remmaTech12/omni-wheel/inverted_pendulum/modelling/pictures/animation/image/img_0.png

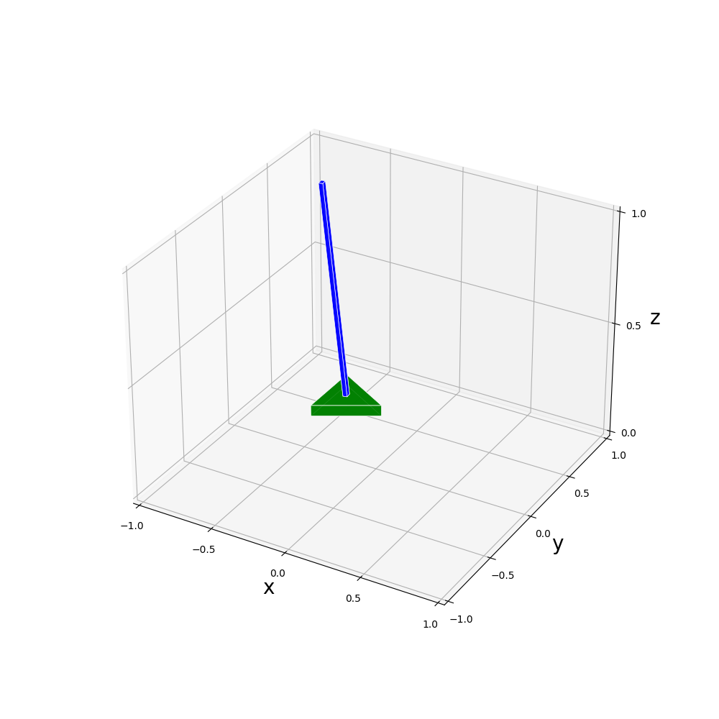
inverted_pendulum/modelling/pictures/animation/image/img_0.png
