remmaTech12/omni-wheel/inverted_pendulum/modelling/pictures/animation/image/img_8.png

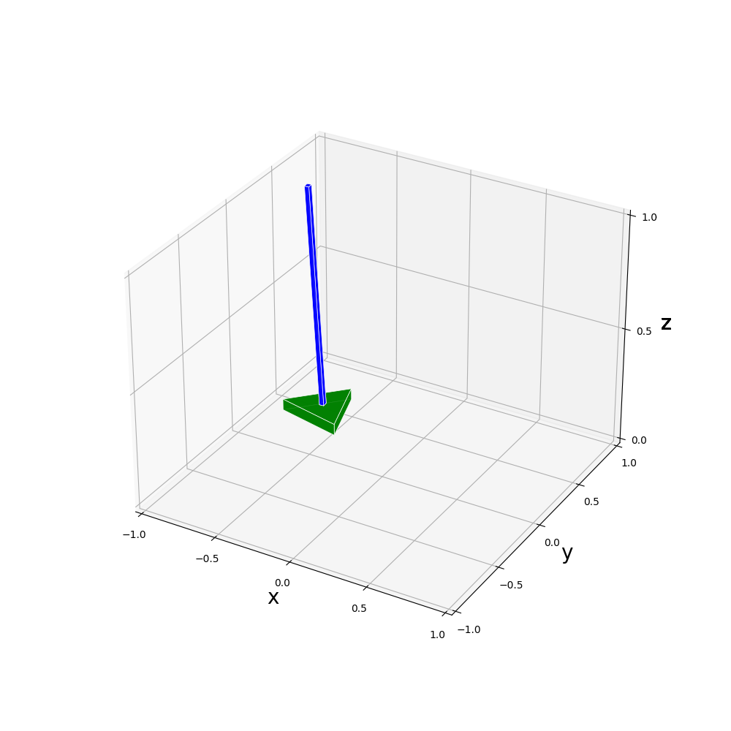
inverted_pendulum/modelling/pictures/animation/image/img_8.png
