remmaTech12/omni-wheel/inverted_pendulum/modelling/pictures/animation/image/img_51.png

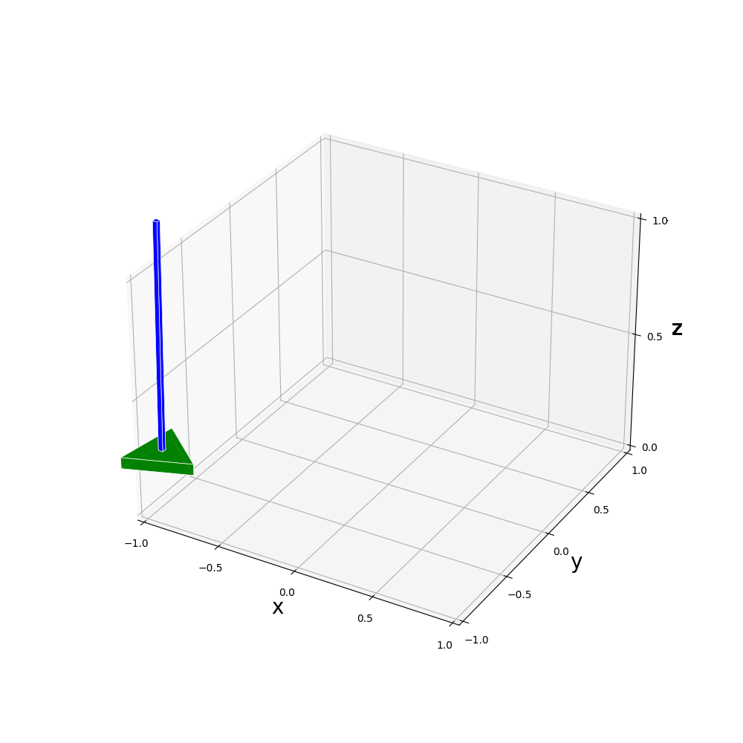
inverted_pendulum/modelling/pictures/animation/image/img_51.png
