remmaTech12/omni-wheel/inverted_pendulum/modelling/pictures/base_animation.png

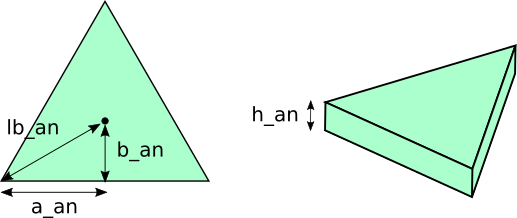
inverted_pendulum/modelling/pictures/base_animation.png
