remmaTech12/omni-wheel/inverted_pendulum/modelling/pictures/input.png

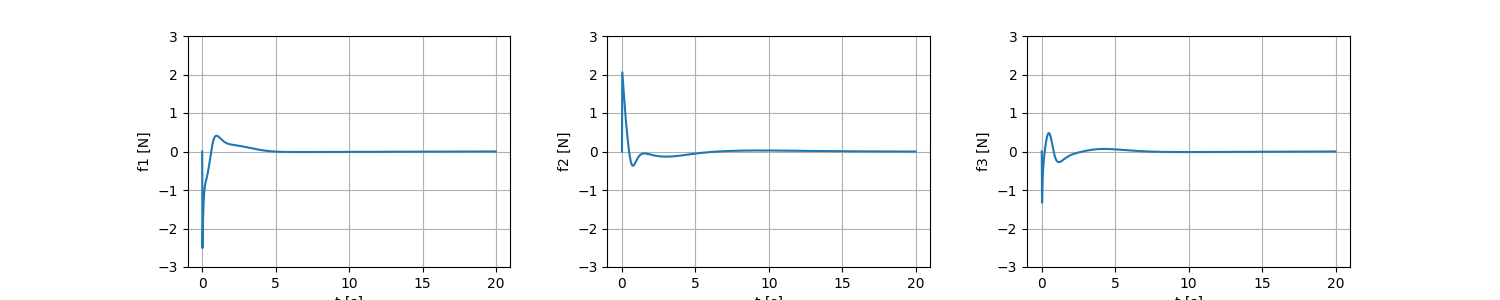
inverted_pendulum/modelling/pictures/input.png
