remmaTech12/omni-wheel/inverted_pendulum/modelling/pictures/modelling.png

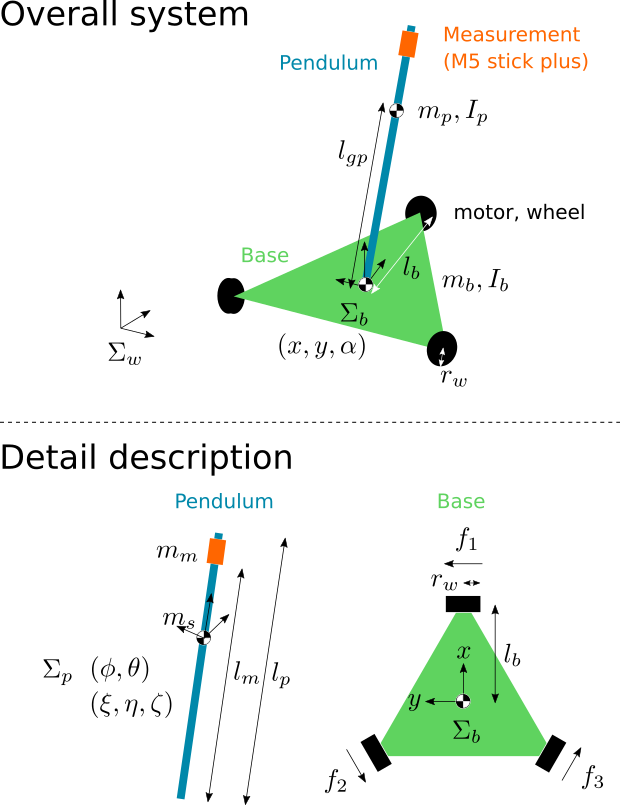
inverted_pendulum/modelling/pictures/modelling.png
