remmaTech12/omni-wheel/inverted_pendulum/modelling/pictures/modelling_2d.png

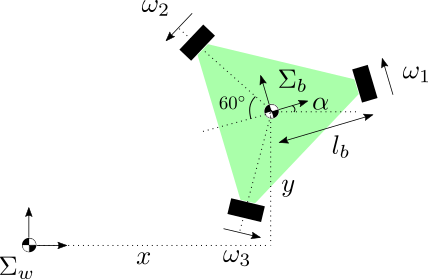
inverted_pendulum/modelling/pictures/modelling_2d.png
