remmaTech12/omni-wheel/inverted_pendulum/modelling/pictures/pendulum_offset.png

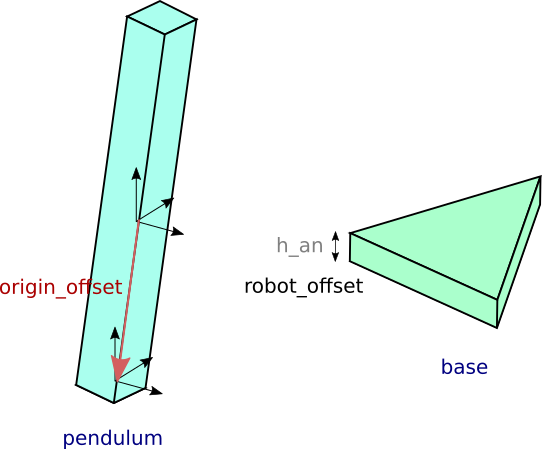
inverted_pendulum/modelling/pictures/pendulum_offset.png
