remmaTech12/omni-wheel/inverted_pendulum/modelling/pictures/phitheta.png

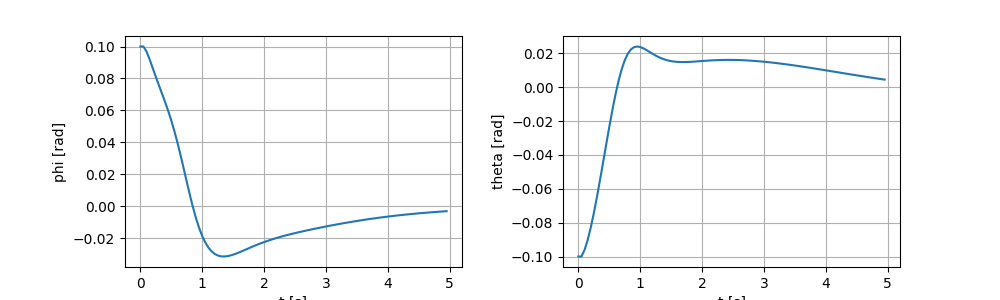
inverted_pendulum/modelling/pictures/phitheta.png
