remmaTech12/omni-wheel/inverted_pendulum/modelling/pictures/xyalpha.png

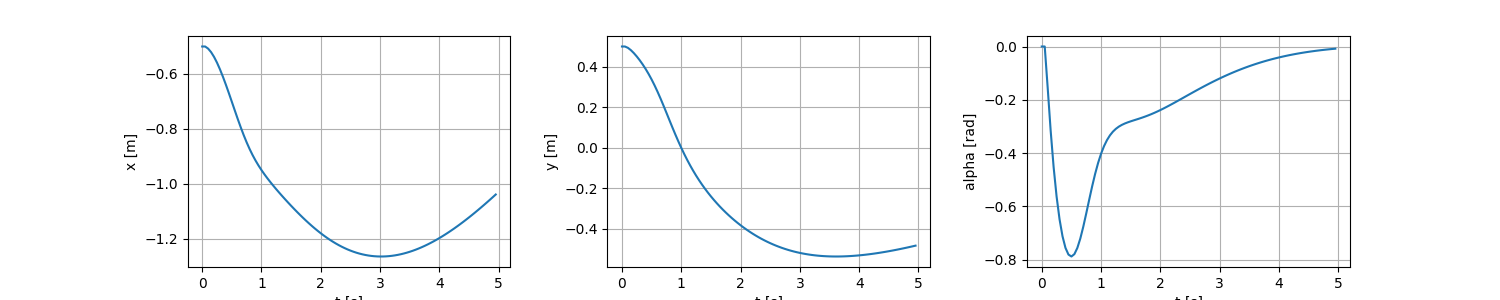
inverted_pendulum/modelling/pictures/xyalpha.png
