remmaTech12/omni-wheel/circuit/remote_controller/remote_controller_bom_pcbway.xlsx

Sheet: remote controller
 |  |  | Remote controller BOM
Item # | *Designator | *Qty | Manufacturer | *Mfg Part # | Value | Description / Value | *Package/Footprint | Type | Purchase Link | Your Instructions / Notes
1 | C1, C4, | 2 | KYOCERA AVX | 0603YD106MAT2A | 10uF | Unpolarized capacitor | 0603 inch | SMD | https://www.mouser.jp/ProductDetail/KYOCERA-AVX/0603YD106MAT2A
2 | C2, C5, C6, C8, | 4 | KEMET | C0603C104K1RACTU | 0.1uF | Unpolarized capacitor | 0603 inch | SMD | https://www.mouser.jp/ProductDetail/KEMET/C0603C104K1RACTU
3 | C3, | 1 | KYOCERA AVX | KAF15BR71E224KT | 22uF | Unpolarized capacitor | 0603 inch | SMD | https://www.mouser.jp/ProductDetail/KYOCERA-AVX/KAF15BR71E224KT
4 | C7, | 1 | KEMET | C0603C475K8PACTU | 4.7uF | Unpolarized capacitor | 0603 inch | SMD | https://www.mouser.jp/ProductDetail/KEMET/C0603C475K8PACTU
5 | D1, D3, D4, D6, D7, D8, D9, D10, D11, D12, D13, | 11 | Bivar | SM0603UBWC | LED | Light emitting diode | 0603 inch | SMD | https://www.mouser.jp/ProductDetail/Bivar/SM0603UBWC?qs=hWDdE2Pc5RAVU9aZAE1txQ%3D%3D
6 | D2, | 1 | Littelfuse | SP0503BAHTG | SP0503BAHT | TVS Diode Array, 5.5V Standoff, 3 Channels SOT-143 package | SOT-143 | SMD | https://www.mouser.jp/ProductDetail/Littelfuse/SP0503BAHTG?qs=uD%2FdkN7XIa0NTYXwHdELYA%3D%3D
7 | D5, | 1 | Bourns | CD0603-B0340R | D_Schottky | Schottky diode | 0603 inch | SMD | https://www.mouser.jp/ProductDetail/Bourns/CD0603-B0340R?qs=xhbEVWpZdWee9K23%252B3DSjQ%3D%3D
8 | J1, | 1 |  |  | Male connector | Generic connector, single row, 01x02, script generated | 1x02_P2.54mm | THT |  | No need to mount this part on the board
9 | J2, | 1 | Amphenol Commercial Products | 12401610E4#2A | USB_C_Receptacle_USB2.0 | USB 2.0-only Type-C Receptacle connector | USB_C_Receptacle | SMD | https://www.mouser.jp/ProductDetail/Amphenol-Commercial-Products/12401610E42A?qs=EgDjlb95zqAWvChv41w5lg%3D%3D
10 | Q1, Q2, | 2 | Comchip Technology | SS8050-G | SS8050-G | Low Voltage High Current NPN Transistor | SOT-23 | SMD | https://www.mouser.jp/ProductDetail/Comchip-Technology/SS8050-G
11 | R1, R2, R4, R12, | 4 | Vishay / Beyschlag | MCT0603MG1002BP500 | 10kΩ | Resistor | 0603 inch | SMD | https://www.mouser.jp/ProductDetail/Vishay-Beyschlag/MCT0603MG1002BP500?qs=Y0Uzf4wQF3kTztUxcSxY1w%3D%3D
12 | R3, | 1 | Vishay / Beyschlag | MCT06030C1470FP500 | 147Ω | Resistor | 0603 inch | SMD | https://www.mouser.jp/ProductDetail/Vishay-Beyschlag/MCT06030C1470FP500
13 | R5, | 1 | YAGEO | RT0603BRB0722K1L | 22.1kΩ | Resistor | 0603 inch | SMD | https://www.mouser.jp/ProductDetail/YAGEO/RT0603BRB0722K1L
14 | R6, R10, | 2 | Vishay / Dale | RCS06035K10FKEA | 5.1kΩ | Resistor | 0603 inch | SMD | https://www.mouser.jp/ProductDetail/Vishay-Dale/RCS06035K10FKEA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
15 | R7, R8, R19, R20, R21, R22, R27, R28, R29, R30, | 10 | Littelfuse | 0603L001/60YR | 100Ω | Resistor | 0603 inch | SMD | https://www.mouser.jp/ProductDetail/Littelfuse/0603L001-60YR?qs=vmHwEFxEFR%252Bqpk0gfi6KUQ%3D%3D
16 | R9, | 1 | Vishay / Dale | TNPW060347K5BEEA | 47.5kΩ | Resistor | 0603 inch | SMD | https://www.mouser.jp/ProductDetail/Vishay-Dale/TNPW060347K5BEEA
17 | R11, | 1 | Vishay / BC Components | NTCS0603E3202GLT | 2kΩ | Resistor | 0603 inch | SMD | https://www.mouser.jp/ProductDetail/Vishay-BC-Components/NTCS0603E3202GLT?qs=%2FWiulJ9oly6RDPZsx8Fw8g%3D%3D
18 | R13, R14, | 2 | Vishay / Beyschlag | MCT0603HZ0000ZP500 | 0Ω | Resistor | 0603 inch | SMD | https://www.mouser.jp/ProductDetail/Vishay-Beyschlag/MCT0603HZ0000ZP500
19 | R15, R16, R17, R18, R23 R24, R25, R26, | 8 | Vishay / BC Components | NTCS0603E3502FLT | 5kΩ | Resistor | 0603 inch | SMD | https://www.mouser.jp/ProductDetail/Vishay-BC-Components/NTCS0603E3502FLT?qs=doiCPypUmgFTT6mDFv6oKA%3D%3D
20 | SW1, SW2, | 2 | C&K | KMR231NGLFS | SW_Push | Push button switch, generic, two pins | KMR2 | SMD | https://www.mouser.jp/ProductDetail/CK/KMR231NGLFS?qs=sb%252But3Lm4x1Y5NsXXdZx2g%3D%3D
21 | SW3, SW4, SW5, SW6, SW7, SW8, SW9, SW10, | 8 | Diptronics | DTSM-65N-V-B | SW_Push | Push button switch, generic, two pins | 6x6mm_H9.5mm | SMD | https://www.mouser.jp/ProductDetail/Diptronics/DTSM-65N-V-B?qs=gTYE2QTfZfSXwXAGPNekUg%3D%3D
22 | U1, | 1 | Analog Devices | LT1963AEST-3.3#PBF | LT1963AxST-3.3 | 3.3V, 1.5A, Low Noise, Fast Transient Response LDO Regulator, SOT-223 | SOT-223-3 | SMD | https://www.mouser.jp/ProductDetail/Analog-Devices/LT1963AEST-3.3PBF?qs=ytflclh7QUWACCdXyVJ5gA%3D%3D
23 | U2, | 1 | Espressif Systems | ESP32-WROVER-B-N8R8 | ESP32-WROVER-B | ESP32-WROVER-B | ESP32-WROVER-B | SMD | https://www.digikey.jp/ja/products/detail/espressif-systems/ESP32-WROVER-B-N8R8/9857843 | Should have 技適 mark to use in Japan.
24 | U3, | 1 | Silicon Labs | CP2102N-A02-GQFN28 | CP2102N-Axx-xQFN28 | USB to UART master bridge, QFN-28 | Package_DFN_QFN: QFN-28-1EP 5x5mm_P0.5mm_EP3.35x3.35mm | SMD | https://www.mouser.jp/ProductDetail/Silicon-Labs/CP2102N-A02-GQFN28?qs=u16ybLDytRaSBkSkyjYFiA%3D%3D

Sheet: sample
Item # | *Designator | *Qty | Manufacturer | *Mfg Part # | Description / Value | *Package/Footprint | Type | Your Instructions / Notes
1 | U1 | 1 | Linear | LTC3780EG#PBF | IC BUCK-BOOST CONV 24-SSOP | 24-SSOP | SMD
2 | U2,U4 | 2 | Fairchild | LM2904M | IC OPAMP DUAL -40-85 C 8-SOIC | 8-SOIC | DNS
3 | U3 | 1 | ON | LM317MBDTG | LM317M IC REG VOLT ADJ 500MA DPAK | DPAK | SMD
4 | U5 | 1 | Microchip | PIC16F690-I/SS | IC PIC MCU FLASH 4KX14 20SSOP | 20SSOP | SMD
5 | Q1 | 1 | Diodes Inc | GBJ10005-F | RECT BRIDGE GPP 50V 10A GBJ | GBJ | SMD
6 | R14,R18 | 2 | Panasonic | ERJ-6ENF4701V | RES 4.70K OHM 1/8W 1% 0805 SMD | 0805 | SMD
7 | R15 | 1 | Susumu | RL3720WT-R022-F | RES .022 OHM 1W 1% 0815 SMD | 0815 | SMD
8 | R16, R31 | 2 | Panasonic | ERJ-6ENF4702V | RES 47.0K OHM 1/8W 1% 0805 SMD | 0805 | SMD
9 | C5 | 1 | Murata | GRM21BR71C225KA12L | CAP CER 2.2UF 16V X7R 0805 | 0805 | SMD
10 | C7 | 1 | Murata | GRM21BR71C475KA73L | CAP CER 4.7UF 16V X7R 0805 | 0805 | DNS
11 | C8,C22 | 2 | Muruta | GRM21BR71C105KA01L | CAP CER 1.0UF 16V 10% X7R 0805 | 0805 | SMD
12 | CN6 | 1 | Molex | 538-53398-0671 | 1.25mm Connectors VERTICAL HDR SMT 6P | SMT 6P | SMD
13 | L1,L2 | 2 | Coiltronics | DR127-150-R | INDUCTOR SHIELD PWR 15UH SMD | SMD | SMD
14 | L3 | 1 | TDK | ACM1211-102-2PL-TL | CHOKE COMM MODE 1000 OHM 6A SM | SMD | SMD
15 | CN3,CN4 | 2 | Molex | 53047-0510 | CONN HEADER 5POS 1.25MM VERT TIN | 5POS | thru-hole

Sheet: kicad sheet
Reference | Quantity | Value | Component name | Description | Footprint | Purchase link
C1, C4, | 2 | 10u | C | Unpolarized capacitor | Capacitor_SMD:C_0603_1608Metric | https://www.mouser.jp/ProductDetail/KYOCERA-AVX/0603YD106MAT2A
C2, C5, C6, C8, | 4 | 0.1u | C | Unpolarized capacitor | Capacitor_SMD:C_0603_1608Metric | https://www.mouser.jp/ProductDetail/KEMET/C0603C104K1RACTU
C3, | 1 | 22u | C | Unpolarized capacitor | Capacitor_SMD:C_0603_1608Metric | https://www.mouser.jp/ProductDetail/KYOCERA-AVX/KAF15BR71E224KT
C7, | 1 | 4.7u | C | Unpolarized capacitor | Capacitor_SMD:C_0603_1608Metric | https://www.mouser.jp/ProductDetail/KEMET/C0603C475K8PACTU
D1, D3, D4, D6, D7, D8, D9, D10, D11, D12, D13, | 11 | LED | LED | Light emitting diode | Diode_SMD:D_0603_1608Metric | https://www.mouser.jp/ProductDetail/Bivar/SM0603UBWC?qs=hWDdE2Pc5RAVU9aZAE1txQ%3D%3D
D2, | 1 | SP0503BAHT | SP0503BAHT | TVS Diode Array, 5.5V Standoff, 3 Channels, SOT-143 package | Package_TO_SOT_SMD:SOT-143 | https://www.mouser.jp/ProductDetail/Littelfuse/SP0503BAHTG?qs=uD%2FdkN7XIa0NTYXwHdELYA%3D%3D
D5, | 1 | D_Schottky | D_Schottky | Schottky diode | Diode_SMD:D_0603_1608Metric | https://www.mouser.jp/ProductDetail/Bourns/CD0603-B0340R?qs=xhbEVWpZdWee9K23%252B3DSjQ%3D%3D
J1, | 1 | Conn_01x02_Male | Conn_01x02_Male | Generic connector, single row, 01x02, script generated | Connector_PinHeader_2.54mm:PinHeader_1x02_P2.54mm_Vertical
J2, | 1 | USB_C_Receptacle_USB2.0 | USB_C_Receptacle_USB2.0 | USB 2.0-only Type-C Receptacle connector | Connector_USB:USB_C_Receptacle_Amphenol_12401610E4-2A | https://www.mouser.jp/ProductDetail/Amphenol-Commercial-Products/12401610E42A?qs=EgDjlb95zqAWvChv41w5lg%3D%3D
Q1, Q2, | 2 | SS8050-G | S8050 | 0.7A Ic, 20V Vce, Low Voltage High Current NPN Transistor, TO-92 | Package_TO_SOT_SMD:SOT-23 | https://www.mouser.jp/ProductDetail/Comchip-Technology/SS8050-G
R1, R2, R4, R12, | 4 | 10k | R | Resistor | Resistor_SMD:R_0603_1608Metric | https://www.mouser.jp/ProductDetail/Vishay-Beyschlag/MCT0603MG1002BP500?qs=Y0Uzf4wQF3kTztUxcSxY1w%3D%3D
R3, | 1 | 147 | R | Resistor | Resistor_SMD:R_0603_1608Metric | https://www.mouser.jp/ProductDetail/Vishay-Beyschlag/MCT06030C1470FP500
R5, | 1 | 22.1k | R | Resistor | Resistor_SMD:R_0603_1608Metric | https://www.mouser.jp/ProductDetail/YAGEO/RT0603BRB0722K1L
R6, R10, | 2 | 5.1k | R | Resistor | Resistor_SMD:R_0603_1608Metric | https://www.mouser.jp/ProductDetail/Vishay-Dale/RCS06035K10FKEA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
R7, R8, R19, R20, R21, R22, R27, R28, R29, R30, | 10 | 100 | R | Resistor | Resistor_SMD:R_0603_1608Metric | https://www.mouser.jp/ProductDetail/Littelfuse/0603L001-60YR?qs=vmHwEFxEFR%252Bqpk0gfi6KUQ%3D%3D
R9, | 1 | 47.5k | R | Resistor | Resistor_SMD:R_0603_1608Metric | https://www.mouser.jp/ProductDetail/Vishay-Dale/TNPW060347K5BEEA
R11, | 1 | 2k | R | Resistor | Resistor_SMD:R_0603_1608Metric | https://www.mouser.jp/ProductDetail/Vishay-BC-Components/NTCS0603E3202GLT?qs=%2FWiulJ9oly6RDPZsx8Fw8g%3D%3D
R13, R14, | 2 | 0 | R | Resistor | Resistor_SMD:R_0603_1608Metric | https://www.mouser.jp/ProductDetail/Vishay-Beyschlag/MCT0603HZ0000ZP500
R15, R16, R17, R18, R23, R24, R25, R26, | 8 | 5k | R | Resistor | Resistor_SMD:R_0603_1608Metric | https://www.mouser.jp/ProductDetail/Vishay-BC-Components/NTCS0603E3502FLT?qs=doiCPypUmgFTT6mDFv6oKA%3D%3D
SW1, SW2, | 2 | SW_Push | SW_Push | Push button switch, generic, two pins | Button_Switch_SMD:SW_Push_1P1T_NO_CK_KMR2 | https://www.mouser.jp/ProductDetail/CK/KMR231NGLFS?qs=sb%252But3Lm4x1Y5NsXXdZx2g%3D%3D
SW3, SW4, SW5, SW6, SW7, SW8, SW9, SW10, | 8 | SW_Push | SW_Push | Push button switch, generic, two pins | Button_Switch_SMD:SW_Push_1P1T_NO_6x6mm_H9.5mm | https://www.mouser.jp/ProductDetail/Diptronics/DTSM-65N-V-B?qs=gTYE2QTfZfSXwXAGPNekUg%3D%3D
U1, | 1 | LT1963AxST-3.3 | LT1963AxST-3.3 | 3.3V, 1.5A, Low Noise, Fast Transient Response LDO Regulator, SOT-223 | Package_TO_SOT_SMD:SOT-223-3_TabPin2 | https://www.mouser.jp/ProductDetail/Analog-Devices/LT1963AEST-3.3PBF?qs=ytflclh7QUWACCdXyVJ5gA%3D%3D
U2, | 1 | ESP32-WROVER-B | ESP32-WROVER-B | ESP32-WROVER-B | ESP32-WROVER-B:MODULE_ESP32-WROVER-B | https://www.digikey.jp/ja/products/detail/espressif-systems/ESP32-WROVER-B-N8R8/9857843
U3, | 1 | CP2102N-Axx-xQFN28 | CP2102N-Axx-xQFN28 | USB to UART master bridge, QFN-28 | Package_DFN_QFN:QFN-28-1EP_5x5mm_P0.5mm_EP3.35x3.35mm | https://www.mouser.jp/ProductDetail/Silicon-Labs/CP2102N-A02-GQFN28?qs=u16ybLDytRaSBkSkyjYFiA%3D%3D
