remmaTech12/omni-wheel/circuit/remote_controller/purchase_order/bom.xls

PCBWay Bom Quotation, Product No.:T-1JP1W790621A
Item # | *Designator | *Qty | Manufacturer | *Mfg Part # | Description / Value | Vendor Part # | *Package/Footprint | Mounting Type | Your Instructions / Notes | *Unit Price(1 set) | *Total | *Delivery Time | *Actual Purchase Mfg Part # | *PCBWay Note | Customer Reply | PCBWay Update
1 | C1, C4 | 2 | KYOCERA AVX | 0603YD106MAT2A | 10uF『 』Unpolarized capacitor | https://www.mouser.jp/ProductDetail/KYOCERA-AVX/0603YD106MAT2A | 0603 inch | SMD |  | $1.084 | $2.168 | 7-10 Workdays
2 | C2, C5, C6, C8 | 4 | KEMET | C0603C104K1RACTU | 0.1uF『 』Unpolarized capacitor | https://www.mouser.jp/ProductDetail/KEMET/C0603C104K1RACTU | 0603 inch | SMD |  | $0.255 | $1.020 | 15 Workdays
3 | C3 | 1 | KYOCERA AVX | KAF15BR71E224KT | 22uF『 』Unpolarized capacitor | https://www.mouser.jp/ProductDetail/TAIYO-YUDEN/MEASP105CB5226MF1A01?qs=Z%252BL2brAPG1ICjjPsHUfgZw%3D%3D | 0603 inch | SMD |  | $1.303 | $1.303 | 15 Workdays | 06034D226MAT2A
4 | C7 | 1 | KEMET | C0603C475K8PACTU | 4.7uF『 』Unpolarized capacitor | https://www.mouser.jp/ProductDetail/KEMET/C0603C475K8PACTU | 0603 inch | SMD |  | $0.364 | $0.364 | 15 Workdays
5 | D1, D3, D4, D6, D7, D8,D9, D10, D11, D12, D13 | 11 | Bivar | SM0603UBWC | LED『 』Light emitting diode | https://www.mouser.jp/ProductDetail/Bivar/SM0603UBWC?qs=hWDdE2Pc5RAVU9aZAE1txQ%3D%3D | 0603 inch | SMD |  | $1.163 | $12.793 | 7-10 Workdays
6 | D2 | 1 | Littelfuse | SP0503BAHTG | SP0503BAHT『 』TVS Diode Array, 5.5V Standoff, 3 ChannelsSOT-143 package | https://www.mouser.jp/ProductDetail/Littelfuse/SP0503BAHTG?qs=uD%2FdkN7XIa0NTYXwHdELYA%3D%3D | SOT-143 | SMD |  | $0.191 | $0.191
7 | D5 | 1 | Bourns | CD0603-B0340R | D_Schottky『 』Schottky diode | https://www.mouser.jp/ProductDetail/Bourns/CD0603-B0340R?qs=xhbEVWpZdWee9K23%252B3DSjQ%3D%3D | 0603 inch | SMD |  | $0.404 | $0.404 | 15 Workdays
8 | J1 | 1 |  |  | Male connector『 』Generic connector, single row,01x02, script generated |  | 1x02_P2.54mm | THT | No need to mount this part on the board |  |  |  |  | 不买不贴[DNP不要贴];
9 | J2 | 1 | Amphenol Commercial Products | 12401610E4#2A | USB_C_Receptacle_USB2.0『 』USB 2.0-only Type-C Receptacle connector | https://www.mouser.jp/ProductDetail/Amphenol-Commercial-Products/12401610E42A?qs=EgDjlb95zqAWvChv41w5lg%3D%3D | USB_C_Receptacle | SMD |  | $4.365 | $4.365 | 7-10 Workdays
10 | Q1, Q2 | 2 | Comchip Technology | SS8050-G | SS8050-G『 』Low Voltage High Current NPN Transistor | https://www.mouser.jp/ProductDetail/Comchip-Technology/SS8050-G | SOT-23 | SMD |  | $0.688 | $1.376 | 7-10 Workdays
11 | R1, R2, R4, R12 | 4 | Vishay / Beyschlag | MCT0603MG1002BP500 | 10kΩ『 』Resistor | https://www.mouser.jp/ProductDetail/Vishay-Beyschlag/MCT0603MG1002BP500?qs=Y0Uzf4wQF3kTztUxcSxY1w%3D%3D | 0603 inch | SMD |  | $2.211 | $8.844 | 7-10 Workdays
12 | R3 | 1 | Vishay / Beyschlag | MCT06030C1470FP500 | 147Ω『 』Resistor | https://www.mouser.jp/ProductDetail/Vishay-Beyschlag/MCT06030C1470FP500 | 0603 inch | SMD |  | $0.277 | $0.277 | 7-10 Workdays
13 | R5 | 1 | YAGEO | RT0603BRB0722K1L | 22.1kΩ『 』Resistor | https://www.mouser.jp/ProductDetail/YAGEO/RT0603BRB0722K1L | 0603 inch | SMD |  | $1.196 | $1.196 | 7-10 Workdays
14 | R6, R10 | 2 | Vishay / Dale | RCS06035K10FKEA | 5.1kΩ『 』Resistor | https://www.mouser.jp/ProductDetail/Vishay-Dale/RCS06035K10FKEA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 | 0603 inch | SMD |  | $0.104 | $0.208 | 15 Workdays
15 | R7, R8, R19, R20, R21,R22, R27, R28, R29, R30 | 10 | Littelfuse | 0603L001/60YR | 100Ω『 』Resistor | https://www.mouser.jp/ProductDetail/Littelfuse/0603L001-60YR?qs=vmHwEFxEFR%252Bqpk0gfi6KUQ%3D%3D | 0603 inch | SMD |  | $1.731 | $17.310 | 7-10 Workdays
16 | R9 | 1 | Vishay / Dale | TNPW060347K5BEEA | 47.5kΩ『 』Resistor | https://www.mouser.jp/ProductDetail/Vishay-Dale/TNPW060347K5BEEA | 0603 inch | SMD |  | $0.738 | $0.738 | 15 Workdays
17 | R11 | 1 | Vishay / BC Components | NTCS0603E3202GLT | 2kΩ『 』Resistor | https://www.mouser.jp/ProductDetail/Vishay-BC-Components/NTCS0603E3202GLT?qs=%2FWiulJ9oly6RDPZsx8Fw8g%3D%3D | 0603 inch | SMD |  | $4.677 | $4.677 | 7-10 Workdays
18 | R13, R14 | 2 | Vishay / Beyschlag | MCT0603HZ0000ZP500 | 0Ω『 』Resistor | https://www.mouser.jp/ProductDetail/Vishay-Beyschlag/MCT0603HZ0000ZP500 | 0603 inch | SMD |  | $0.561 | $1.122 | 7-10 Workdays
19 | R15, R16, R17, R18, R23R24, R25, R26 | 8 | Vishay / BC Components | NTCS0603E3502FLT | 5kΩ『 』Resistor | https://www.mouser.jp/ProductDetail/Vishay-BC-Components/NTCS0603E3502FLT?qs=doiCPypUmgFTT6mDFv6oKA%3D%3D | 0603 inch | SMD |  | $0.697 | $5.576 | 15 Workdays
20 | SW1, SW2 | 2 | C&K | KMR231NGLFS | SW_Push『 』Push button switch, generic, two pins | https://www.mouser.jp/ProductDetail/CK/KMR231NGLFS?qs=sb%252But3Lm4x1Y5NsXXdZx2g%3D%3D | KMR2 | SMD |  | $1.188 | $2.376 | 15 Workdays | KMR231NG LFS
21 | SW3, SW4, SW5, SW6, SW7,SW8, SW9, SW10 | 8 | Diptronics | DTSM-65N-V-B | SW_Push『 』Push button switch, generic, two pins | https://www.mouser.jp/ProductDetail/Diptronics/DTSM-65N-V-B?qs=gTYE2QTfZfSXwXAGPNekUg%3D%3D | 6x6mm_H9.5mm | SMD |  | $0.591 | $4.728 | 7-10 Workdays
22 | U1 | 1 | Analog Devices | LT1963AEST-3.3#PBF | LT1963AxST-3.3『 』3.3V,1.5A,LowNoise,FastTransientResponseLDORegulator,SOT-223 | https://www.mouser.jp/ProductDetail/Analog-Devices/LT1963AEST-3.3PBF?qs=ytflclh7QUWACCdXyVJ5gA%3D%3D | SOT-223-3 | SMD |  | $10.854 | $10.854 | 15 Workdays
23 | U2 | 1 | Espressif Systems | ESP32-WROVER-B-N8R8 | ESP32-WROVER-B『 』ESP32-WROVER-B | https://www.digikey.jp/ja/products/detail/espressif-systems/ESP32-WROVER-B-N8R8/9857843 | ESP32-WROVER-B | SMD | Should have 技適 mark to use in Japan. | $13.671 | $13.671 |  |  | Should have 技適 mark to use in Japan.
24 | U3 | 1 | Silicon Labs | CP2102N-A02-GQFN28 | CP2102N-Axx-xQFN28『 』USB to UART master bridge, QFN-28 | https://www.mouser.jp/ProductDetail/Silicon-Labs/CP2102N-A02-GQFN28?qs=u16ybLDytRaSBkSkyjYFiA%3D%3D | Package_DFN_QFN:QFN-281EP5x5mm_P0.5mm_EP3.35x3.35mm | SMD |  | $6.405 | $6.405 | 15 Workdays
 |  |  |  |  |  |  |  |  |  | Component Cost | $101.97
 |  |  |  |  |  |  |  |  |  | Assembly Cost | $30.00
 |  |  |  |  |  |  |  |  |  | PCB Cost | $58.22
 |  |  |  |  |  |  |  |  |  | V0 Member 0% off | $0.00
 |  |  |  |  |  |  |  |  |  | All Total 1 Sets | $190.19
