remmaTech12/omni-wheel/circuit/omni_wheel/purchase_order/20241202/bom.xls

PCBWay Bom Quotation, Product No.:T-1JP6W790621A
Item # | *Designator | *Qty | Manufacturer | *Mfg Part # | Description / Value | *Package/Footprint | Mounting Type | Your Instructions / Notes | *Unit Price(1 set) | *Total | *Delivery Time | *Actual Purchase Mfg Part # | *PCBWay Note | Customer Reply | PCBWay Update
1 | C1, C6 | 2 | KYOCERA AVX | 0603ZW106MAT2A | 10uF | Capacitor_SMD:C_0603_1608Metric | SMD | https://www.mouser.jp/ProductDetail/KYOCERA-AVX/0603ZW106MAT2A?qs=BZBei1rCqCDILT8BMORbpw%3D%3D | $0.693 | $1.386
2 | C2, C4, C5, C8, C9, C11, C12, C13, C14, C15, C16, C17 | 12 | KYOCERA AVX | KAM15AR71C104KM | 0.1uF | Capacitor_SMD:C_0603_1608Metric | SMD | https://www.mouser.jp/ProductDetail/KYOCERA-AVX/KAM15AR71C104KM?qs=Jm2GQyTW%2FbjvjfiJhcHTCg%3D%3D | $0.139 | $1.668
3 | C3 | 1 | KYOCERA AVX | 0603ZD226MAT2A | 22uF | Capacitor_SMD:C_0603_1608Metric | SMD | https://www.mouser.jp/ProductDetail/KYOCERA-AVX/0603ZD226MAT2A?qs=sSYV1F9c5cE%2FKdrrBmQkqw%3D%3D | $0.504 | $0.504
4 | C7 | 1 | KYOCERA AVX | 06036D475MAT2A | 4.7uF | Capacitor_SMD:C_0603_1608Metric | SMD | https://www.mouser.jp/ProductDetail/KYOCERA-AVX/06036D475MAT2A?qs=G62aafFtBAdLQjkZwFspeQ%3D%3D | $0.231 | $0.231
5 | C10 | 1 | Vishay / Vitramon | VJ0603Y682KXBAC31X | 6.8nF | Capacitor_SMD:C_0603_1608Metric | SMD | https://www.mouser.jp/ProductDetail/Vishay-Vitramon/VJ0603Y682KXBAC31X | $0.567 | $0.567
6 | D1, D2 | 2 | Bivar | SM0603URC | LED | Diode_SMD:D_0603_1608Metric | SMD | https://www.mouser.jp/ProductDetail/Bivar/SM0603URC?qs=hWDdE2Pc5RAmyCtviNtSxQ%3D%3D | $0.512 | $1.024
7 | D3 | 1 | Littelfuse | SP0503BAHTG | SP0503BAHT | Package_TO_SOT_SMD:SOT-143 | SMD | https://www.mouser.jp/ProductDetail/Littelfuse/SP0503BAHTG?qs=uD%2FdkN7XIa0NTYXwHdELYA%3D%3D | $0.415 | $0.415
8 | D4 | 1 | Comchip Technology | CDBU70-HF | D_Schottky | Diode_SMD:D_0603_1608Metric | SMD | https://www.mouser.jp/ProductDetail/Comchip-Technology/CDBU70-HF?qs=2qJf6qQ4IOL3%2FIGqjls%252B4w%3D%3D | $0.982 | $0.982 | 7-10 Workdays
9 | J1 | 1 | Adam Tech | PH1RB-02-UA | Conn_01x02_Male | Connector_PinSocket_2.54mm:PinSocket_1x02_P2.54mm_Vertical | THT | https://www.digikey.jp/ja/products/detail/adam-tech/PH1RB-02-UA/9830333?productid=9830333&gad_source=1 』PCB front side is upward | $0.237 | $0.237 | 7-10 Workdays
10 | J2 | 1 | Amphenol Commercial Products | 12401610E4#2A | USB_C_Receptacle_USB2.0 | Connector_USB:USB_C_Receptacle_Amphenol_12401610E4-2A | SMD | https://www.mouser.jp/ProductDetail/Amphenol-Commercial-Products/12401610E42A?qs=EgDjlb95zqAWvChv41w5lg%3D%3D | $2.013 | $2.013
11 | J3, J4, J5 | 3 | Würth Elektronik | 61300611121 | Conn_01x06_Male | Connector_PinHeader_2.54mm:PinHeader_1x06_P2.54mm_Vertical | THT | https://www.digikey.jp/ja/products/detail/w%C3%BCrth-elektronik/61300611121/4846833?productid=4846833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 』PCB front side is upward | $0.549 | $1.647 | 7-10 Workdays
12 | Q1, Q2 | 2 | Comchip Technology | SS8050-G | SS8050-G | Package_TO_SOT_SMD:SOT-23 | SMD | https://www.mouser.jp/ProductDetail/Comchip-Technology/SS8050-G | $0.512 | $1.024 |  |  | brand:CJ(江苏长电/长晶) ,not Comchip Technology ,pls confirm.
13 | R1, R2, R4, R12, R15, R16, R17, R18, R19, R20 | 10 | Vishay / Beyschlag | MCT06030D1002BP500 | 10kΩ | Resistor_SMD:R_0603_1608Metric | SMD | https://www.mouser.jp/ProductDetail/Vishay-Beyschlag/MCT06030D1002BP500?qs=ncxkyCpAYDAJSzgYSRSsnA%3D%3D | $0.232 | $2.320
14 | R3 | 1 | Vishay / Dale | CRCW0603147RFKTA | 147Ω | Resistor_SMD:R_0603_1608Metric | SMD | https://www.mouser.jp/ProductDetail/Vishay-Dale/CRCW0603147RFKTA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 | $0.092 | $0.092
15 | R5 | 1 | Vishay / BC Components | NTCS0603E3502HLT | 5kΩ | Resistor_SMD:R_0603_1608Metric | SMD | https://www.mouser.jp/ProductDetail/Vishay-BC-Components/NTCS0603E3502HLT?qs=doiCPypUmgFTmF9ZnhJHyQ%3D%3D | $1.470 | $1.470
16 | R6 | 1 | Bourns | CR0603-JW-101ELF | 100Ω | Resistor_SMD:R_0603_1608Metric | SMD | https://www.mouser.jp/ProductDetail/Bourns/CR0603-JW-101ELF?qs=jAUlru4btJFOerhakJcyhQ%3D%3D | $0.042 | $0.042
17 | R7 | 1 | Vishay / Dale | TNPW060322K1BEEA | 22.1kΩ | Resistor_SMD:R_0603_1608Metric | SMD | https://www.mouser.jp/ProductDetail/Vishay-Dale/TNPW060322K1BEEA | $0.504 | $0.504
18 | R8, R10 | 2 | Vishay / Dale | CRCW06035K10FKEC | 5.1kΩ | Resistor_SMD:R_0603_1608Metric | SMD | https://www.mouser.jp/ProductDetail/Vishay-Dale/CRCW06035K10FKEC | $0.185 | $0.370
19 | R9 | 1 | Vishay / Dale | CRCW060347K5FKEAHP | 47.5kΩ | Resistor_SMD:R_0603_1608Metric | SMD | https://www.mouser.jp/ProductDetail/Vishay-Dale/CRCW060347K5FKEAHP | $0.185 | $0.185
20 | R11 | 1 | Vishay / Dale | TNPW06032K00DEEA | 2kΩ | Resistor_SMD:R_0603_1608Metric | SMD | https://www.mouser.jp/ProductDetail/Vishay-Dale/TNPW06032K00DEEA?qs=ZPVAY1QZwKhoQnnDu3aK3Q%3D%3D | $0.504 | $0.504
21 | R13, R14 | 2 | Vishay / Dale | CRCW06030000Z0ED | 0Ω | Resistor_SMD:R_0603_1608Metric | SMD | https://www.mouser.jp/ProductDetail/Vishay-Dale/CRCW06030000Z0ED | $0.185 | $0.370 |  | CRCW06030000Z0EDHP | CRCW06030000Z0ED is incomplete, we will supply Complete part CRCW06030000Z0EDHP，pls confirm.
22 | SW1, SW2 | 2 | C&K | KMR231NGLFS | SW_Push | Button_Switch_SMD:SW_Push_1P1T_NO_CK_KMR2 | SMD | https://www.mouser.jp/ProductDetail/CK/KMR231NGLFS?qs=sb%252But3Lm4x1Y5NsXXdZx2g%3D%3D | $0.910 | $1.820
23 | SW3 | 1 | Diptronics | DTSM-65N-V-B | SW_Push | Button_Switch_SMD:SW_Push_1P1T_NO_6x6mm_H9.5mm | SMD | https://www.mouser.jp/ProductDetail/Diptronics/DTSM-65N-V-B?qs=gTYE2QTfZfSXwXAGPNekUg%3D%3D | $0.451 | $0.451 | 7-10 Workdays
24 | U1 | 1 | Analog Devices | LT1963AEST-3.3#PBF | LT1963AxST-3.3 | Package_TO_SOT_SMD:SOT-223-3_TabPin2 | SMD | https://www.mouser.jp/ProductDetail/Analog-Devices/LT1963AEST-3.3PBF?qs=ytflclh7QUWACCdXyVJ5gA%3D%3D | $4.468 | $4.468
25 | U2 | 1 | Espressif Systems | ESP32-WROVER-B-N8R8 | ESP32-WROVER-B | ESP32-WROVER-B:MODULE_ESP32-WROVER-B | SMD | https://www.digikey.jp/ja/products/detail/espressif-systems/ESP32-WROVER-B-N8R8/9857843『 』Should have 技適 mark to use in Japan | $6.038 | $6.038
26 | U3 | 1 | Silicon Labs | CP2102N-A02-GQFN28 | CP2102N-Axx-xQFN28 | Package_DFN_QFN:QFN-28-1EP_5x5mm_P0.5mm_EP3.35x3.35mm | SMD | https://www.mouser.jp/ProductDetail/Silicon-Labs/CP2102N-A02-GQFN28?qs=u16ybLDytRaSBkSkyjYFiA%3D%3D | $3.019 | $3.019
27 | U4 | 1 | Bosch Sensortec | BNO055 | BNO055 | Package_LGA:LGA-28_5.2x3.8mm_P0.5mm | SMD | https://www.mouser.jp/ProductDetail/Bosch-Sensortec/BNO055?qs=QhAb4EtQfbV8Z2YmISucWw%3D%3D | $11.240 | $11.240
28 | U5, U6, U7 | 3 | Texas Instruments | DRV8837DSGR | DRV8837 | Package_SON:WSON-8-1EP_2x2mm_P0.5mm_EP0.9x1.6mm | SMD | https://www.mouser.jp/ProductDetail/Texas-Instruments/DRV8837DSGR?qs=l6ZoeTYLMwO0pKIJ8222Ww%3D%3D | $0.265 | $0.795
 |  |  |  |  |  |  |  |  | Component Cost | $45.39
 |  |  |  |  |  |  |  |  | Assembly Cost | $29.00
 |  |  |  |  |  |  |  |  | PCB Cost | $63.06
 |  |  |  |  |  |  |  |  | V2 Member 2% off | -$1.84
 |  |  |  |  |  |  |  |  | All Total 1 Sets | $135.60
