remmaTech12/omni-wheel/circuit/omni_wheel/purchase_order/20240831/omni-wheel-base_bom_20240831.xls

PCBWay Bom Quotation, Product No.:
Item # | *Designator | *Qty | Manufacturer | *Mfg Part # | Description / Value | Vendor Part # | *Package/Footprint | Mounting Type | Your Instructions / Notes | *Unit Price(1 set) | *Total | *Delivery Time | *Actual Purchase Mfg Part # | *PCBWay Note | Customer Reply | PCBWay Update
1 | C1, C6, | 2 | KYOCERA AVX | 0603ZW106MAT2A | 10uF | https://www.mouser.jp/ProductDetail/KYOCERA-AVX/0603ZW106MAT2A?qs=BZBei1rCqCDILT8BMORbpw%3D%3D | Capacitor_SMD:C_0603_1608Metric | SMD
2 | C2, C4, C5, C8, C9, C11, C12, C13, C14, C15, C16, C17, | 12 | KYOCERA AVX | KAM15AR71C104KM | 0.1uF | https://www.mouser.jp/ProductDetail/KYOCERA-AVX/KAM15AR71C104KM?qs=Jm2GQyTW%2FbjvjfiJhcHTCg%3D%3D | Capacitor_SMD:C_0603_1608Metric | SMD
3 | C3, | 1 | KYOCERA AVX | 0603ZD226MAT2A | 22uF | https://www.mouser.jp/ProductDetail/KYOCERA-AVX/0603ZD226MAT2A?qs=sSYV1F9c5cE%2FKdrrBmQkqw%3D%3D | Capacitor_SMD:C_0603_1608Metric | SMD
4 | C7, | 1 | KYOCERA AVX | 06036D475MAT2A | 4.7uF | https://www.mouser.jp/ProductDetail/KYOCERA-AVX/06036D475MAT2A?qs=G62aafFtBAdLQjkZwFspeQ%3D%3D | Capacitor_SMD:C_0603_1608Metric | SMD
5 | C10, | 1 | Vishay / Vitramon | VJ0603Y682KXBAC31X | 6.8nF | https://www.mouser.jp/ProductDetail/Vishay-Vitramon/VJ0603Y682KXBAC31X | Capacitor_SMD:C_0603_1608Metric | SMD
6 | D1, D2, | 2 | Bivar | SM0603URC | LED | https://www.mouser.jp/ProductDetail/Bivar/SM0603URC?qs=hWDdE2Pc5RAmyCtviNtSxQ%3D%3D | Diode_SMD:D_0603_1608Metric | SMD
7 | D3, | 1 | Littelfuse | SP0503BAHTG | SP0503BAHT | https://www.mouser.jp/ProductDetail/Littelfuse/SP0503BAHTG?qs=uD%2FdkN7XIa0NTYXwHdELYA%3D%3D | Package_TO_SOT_SMD:SOT-143 | SMD
8 | D4, | 1 | Comchip Technology | CDBU70-HF | D_Schottky | https://www.mouser.jp/ProductDetail/Comchip-Technology/CDBU70-HF?qs=2qJf6qQ4IOL3%2FIGqjls%252B4w%3D%3D | Diode_SMD:D_0603_1608Metric | SMD
9 | D5, | 1 | Diotec Semiconductor | 1N4148W | 1N4148W | https://www.mouser.jp/ProductDetail/Diotec-Semiconductor/1N4148W?qs=OlC7AqGiEDmsbkbAeXQtXg%3D%3D | Diode_SMD:D_SOD-123 | SMD
10 | J1, | 1 |  |  | Conn_01x02_Male |  | Connector_PinSocket_2.54mm:PinSocket_1x02_P2.54mm_Vertical | THT | No need to mount this part on the board
11 | J2, | 1 | Amphenol Commercial Products | 12401610E4#2A | USB_C_Receptacle_USB2.0 | https://www.mouser.jp/ProductDetail/Amphenol-Commercial-Products/12401610E42A?qs=EgDjlb95zqAWvChv41w5lg%3D%3D | Connector_USB:USB_C_Receptacle_Amphenol_12401610E4-2A | THT
12 | J3, J4, J5, | 3 |  |  | Conn_01x06_Male |  | Connector_PinHeader_2.54mm:PinHeader_1x06_P2.54mm_Vertical | THT | No need to mount this part on the board
13 | Q1, Q2, | 2 | Comchip Technology | SS8050-G | SS8050-G | https://www.mouser.jp/ProductDetail/Comchip-Technology/SS8050-G | Package_TO_SOT_SMD:SOT-23 | SMD
14 | R1, R2, R4, R12, R15, R16, R17, R18, R19, R20, | 10 | Vishay / Beyschlag | MCT06030D1002BP500 | 10kΩ | https://www.mouser.jp/ProductDetail/Vishay-Beyschlag/MCT06030D1002BP500?qs=ncxkyCpAYDAJSzgYSRSsnA%3D%3D | Resistor_SMD:R_0603_1608Metric | SMD
15 | R3, | 1 | Vishay / Dale | CRCW0603147RFKTA | 147Ω | https://www.mouser.jp/ProductDetail/Vishay-Dale/CRCW0603147RFKTA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 | Resistor_SMD:R_0603_1608Metric | SMD
16 | R5, | 1 | Vishay / BC Components | NTCS0603E3502HLT | 5kΩ | https://www.mouser.jp/ProductDetail/Vishay-BC-Components/NTCS0603E3502HLT?qs=doiCPypUmgFTmF9ZnhJHyQ%3D%3D | Resistor_SMD:R_0603_1608Metric | SMD
17 | R6, | 1 | Bourns | CR0603-JW-101ELF | 100Ω | https://www.mouser.jp/ProductDetail/Bourns/CR0603-JW-101ELF?qs=jAUlru4btJFOerhakJcyhQ%3D%3D | Resistor_SMD:R_0603_1608Metric | SMD
18 | R7, | 1 | Vishay / Dale | TNPW060322K1BEEA | 22.1kΩ | https://www.mouser.jp/ProductDetail/Vishay-Dale/TNPW060322K1BEEA | Resistor_SMD:R_0603_1608Metric | SMD
19 | R8, R10, | 2 | Vishay / Dale | CRCW06035K10FKEC | 5.1kΩ | https://www.mouser.jp/ProductDetail/Vishay-Dale/CRCW06035K10FKEC | Resistor_SMD:R_0603_1608Metric | SMD
20 | R9, | 1 | Vishay / Dale | CRCW060347K5FKEAHP | 47.5kΩ | https://www.mouser.jp/ProductDetail/Vishay-Dale/CRCW060347K5FKEAHP | Resistor_SMD:R_0603_1608Metric | SMD
21 | R11, | 1 | Vishay / Dale | TNPW06032K00DEEA | 2kΩ | https://www.mouser.jp/ProductDetail/Vishay-Dale/TNPW06032K00DEEA?qs=ZPVAY1QZwKhoQnnDu3aK3Q%3D%3D | Resistor_SMD:R_0603_1608Metric | SMD
22 | R13, R14, | 2 | Vishay / Dale | CRCW06030000Z0ED | 0Ω | https://www.mouser.jp/ProductDetail/Vishay-Dale/CRCW06030000Z0ED | Resistor_SMD:R_0603_1608Metric | SMD
23 | SW1, SW2, | 2 | C&K | KMR231NGLFS | SW_Push | https://www.mouser.jp/ProductDetail/CK/KMR231NGLFS?qs=sb%252But3Lm4x1Y5NsXXdZx2g%3D%3D | Button_Switch_SMD:SW_Push_1P1T_NO_CK_KMR2 | SMD
24 | SW3, | 1 | Diptronics | DTSM-65N-V-B | SW_Push | https://www.mouser.jp/ProductDetail/Diptronics/DTSM-65N-V-B?qs=gTYE2QTfZfSXwXAGPNekUg%3D%3D | Button_Switch_SMD:SW_Push_1P1T_NO_6x6mm_H9.5mm | SMD
25 | SW4, | 1 | C&K | OS102011MS2QS1 | SW_SPDT | https://www.mouser.jp/ProductDetail/CK/OS102011MS2QS1?qs=WtljUlYws5TrGs9OfHrZYw%3D%3D | Button_Switch_THT:SW_Slide_1P2T_CK_OS102011MS2Q | THT
26 | U1, | 1 | Analog Devices | LT1963AEST-3.3#PBF | LT1963AxST-3.3 | https://www.mouser.jp/ProductDetail/Analog-Devices/LT1963AEST-3.3PBF?qs=ytflclh7QUWACCdXyVJ5gA%3D%3D | Package_TO_SOT_SMD:SOT-223-3_TabPin2 | SMD
27 | U2, | 1 | Espressif Systems | ESP32-WROVER-B-N8R8 | ESP32-WROVER-B | https://www.digikey.jp/ja/products/detail/espressif-systems/ESP32-WROVER-B-N8R8/9857843 | ESP32-WROVER-B:MODULE_ESP32-WROVER-B | SMD | Should have 技適 mark to use in Japan.
28 | U3, | 1 | Silicon Labs | CP2102N-A02-GQFN28 | CP2102N-Axx-xQFN28 | https://www.mouser.jp/ProductDetail/Silicon-Labs/CP2102N-A02-GQFN28?qs=u16ybLDytRaSBkSkyjYFiA%3D%3D | Package_DFN_QFN:QFN-28-1EP_5x5mm_P0.5mm_EP3.35x3.35mm | SMD
29 | U4, | 1 | Bosch Sensortec | BNO055 | BNO055 | https://www.mouser.jp/ProductDetail/Bosch-Sensortec/BNO055?qs=QhAb4EtQfbV8Z2YmISucWw%3D%3D | Package_LGA:LGA-28_5.2x3.8mm_P0.5mm | SMD
30 | U5, U6, U7, | 3 | Texas Instruments | DRV8837DSGR | DRV8837 | https://www.mouser.jp/ProductDetail/Texas-Instruments/DRV8837DSGR?qs=l6ZoeTYLMwO0pKIJ8222Ww%3D%3D | Package_SON:WSON-8-1EP_2x2mm_P0.5mm_EP0.9x1.6mm | SMD
 | Total | 60 |  |  |  |  |  |  |  | Component Cost | $0.00
 |  |  |  |  |  |  |  |  |  | Assembly Cost | $30.00
 |  |  |  |  |  |  |  |  |  | PCB Cost | $58.22
 |  |  |  |  |  |  |  |  |  | V0 Member 0% off | $0.00
 |  |  |  |  |  |  |  |  |  | All Total 1 Sets | $88.22
