remmaTech12/omni-wheel/3dprint/omni-wheel-assy-omni-wheel-bracket.dxf

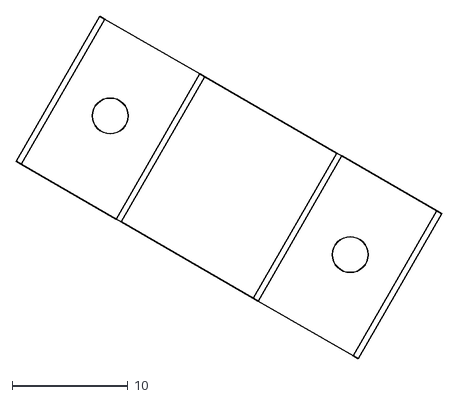
[picture p13: CAD file, 2024-11-07]
3dprint/omni-wheel-assy-omni-wheel-bracket.dxf
36.9 x 29.7
