remmaTech12/omni-wheel/3dprint/omni-wheel-assy.FCStd

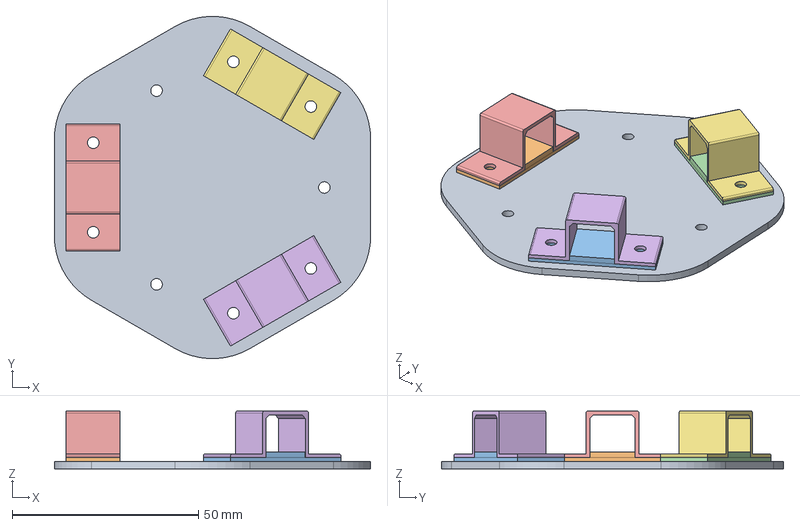
[picture p14: CAD file, 2024-11-07]
3dprint/omni-wheel-assy.FCStd
84.9 x 91.7 x 15.5 mm
omni-wheel-base_001
omni-wheel-bracket-base_001
omni-wheel-bracket-base_002
omni-wheel-bracket-base_003
omni-wheel-bracket_001
omni-wheel-bracket_002
omni-wheel-bracket_003
