remmaTech12/omni-wheel/3dprint/omni-wheel-bracket-base.FCStd

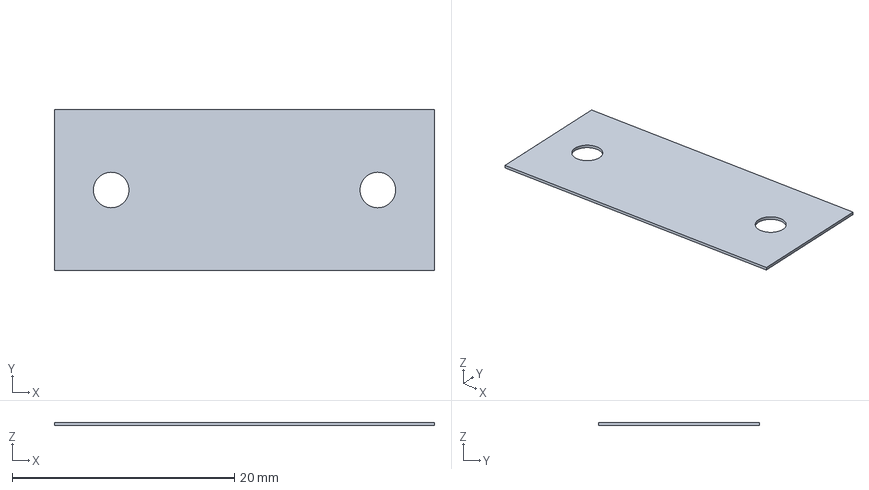
[picture p15: CAD file, 2024-12-26]
3dprint/omni-wheel-bracket-base.FCStd
34.2 x 14.5 x 0.3 mm
