remmaTech12/omni-wheel/3dprint/omni-wheel-bracket.FCStd

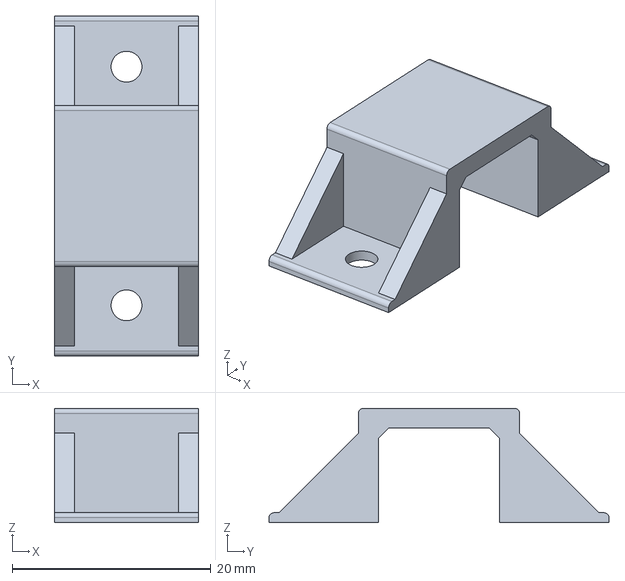
[picture p17: CAD file, 2024-12-20]
3dprint/omni-wheel-bracket.FCStd
14.5 x 34.2 x 11.5 mm
