remmaTech12/omni-wheel/3dprint/omni-wheel-base.FCStd

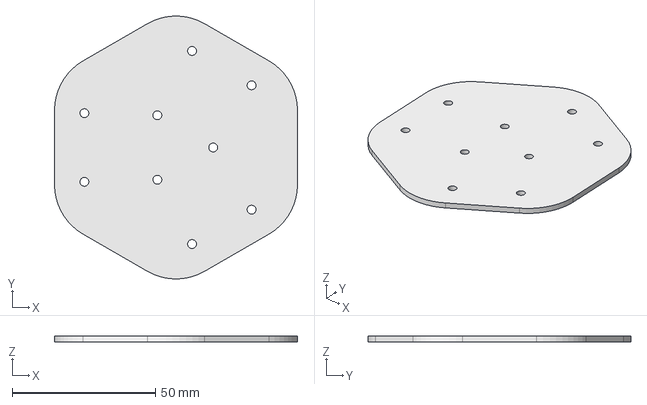
[picture p18: CAD file, 2024-12-01]
3dprint/omni-wheel-base.FCStd
84.9 x 91.7 x 2.00 mm
