remmaTech12/omni-wheel/3dprint/omni-wheel-base-baseFillet.dxf

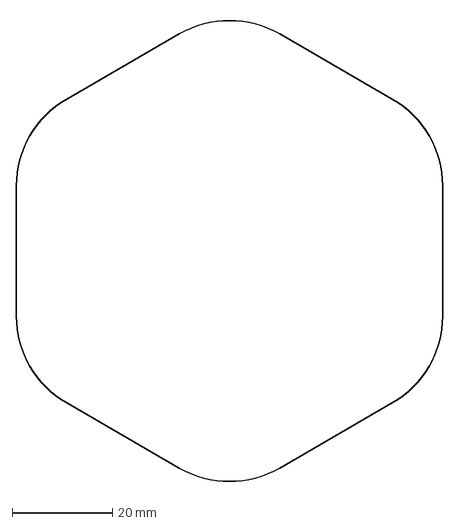
[picture p19: CAD file, 2024-11-07]
3dprint/omni-wheel-base-baseFillet.dxf
84.9 x 93.6 mm
