remmaTech12/omni-wheel/3dprint/omni-wheel-base-base-without-fillet.dxf

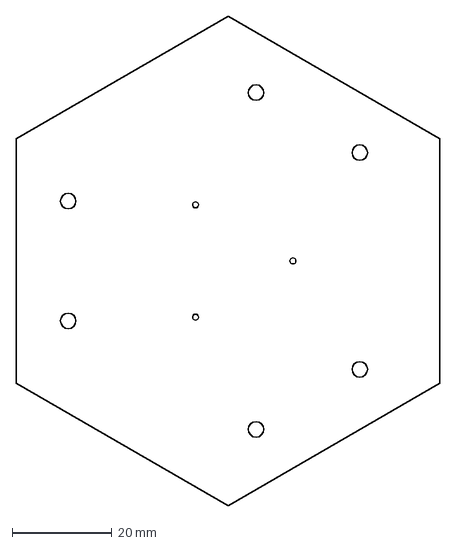
[picture p20: CAD file, 2024-11-07]
3dprint/omni-wheel-base-base-without-fillet.dxf
84.9 x 98.0 mm
