remmaTech12/omni-wheel/3dprint/omni-wheel-base-base-conv.dxf

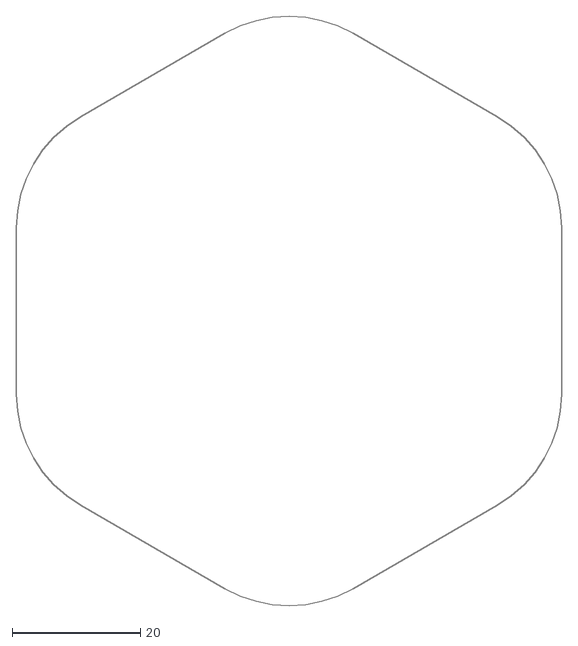
[picture p21: CAD file, 2024-11-07]
3dprint/omni-wheel-base-base-conv.dxf
84.9 x 91.8
