remmaTech12/omni-wheel/(list of files, cad)

Other CAD files:
3dprint/omni-wheel-bracket-bracket.stl
3dprint/omni-wheel-base-base.stl
3dprint/omni-wheel-base-base.dxf
