remmaTech12/omni-wheel/inverted_pendulum/modelling/pictures/animation/test1.gif

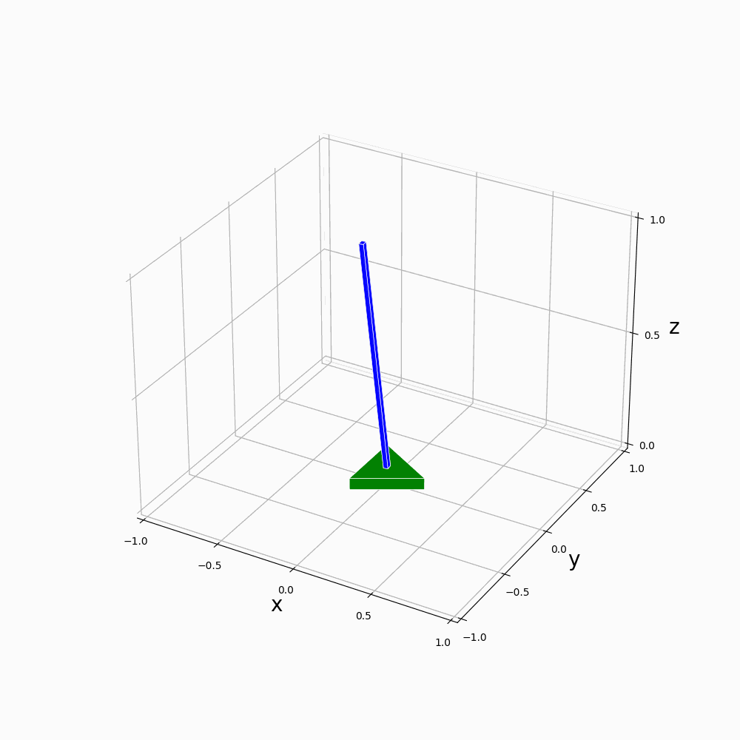
inverted_pendulum/modelling/pictures/animation/test1.gif
