remmaTech12/omni-wheel/inverted_pendulum/modelling/pictures/animation/test.gif

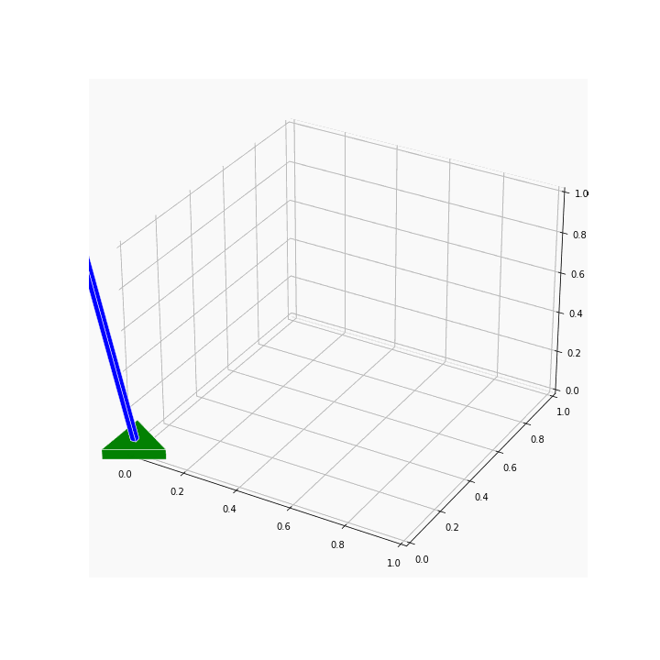
inverted_pendulum/modelling/pictures/animation/test.gif
