remmaTech12/omni-wheel/circuit/omni_wheel/schematic.pdf

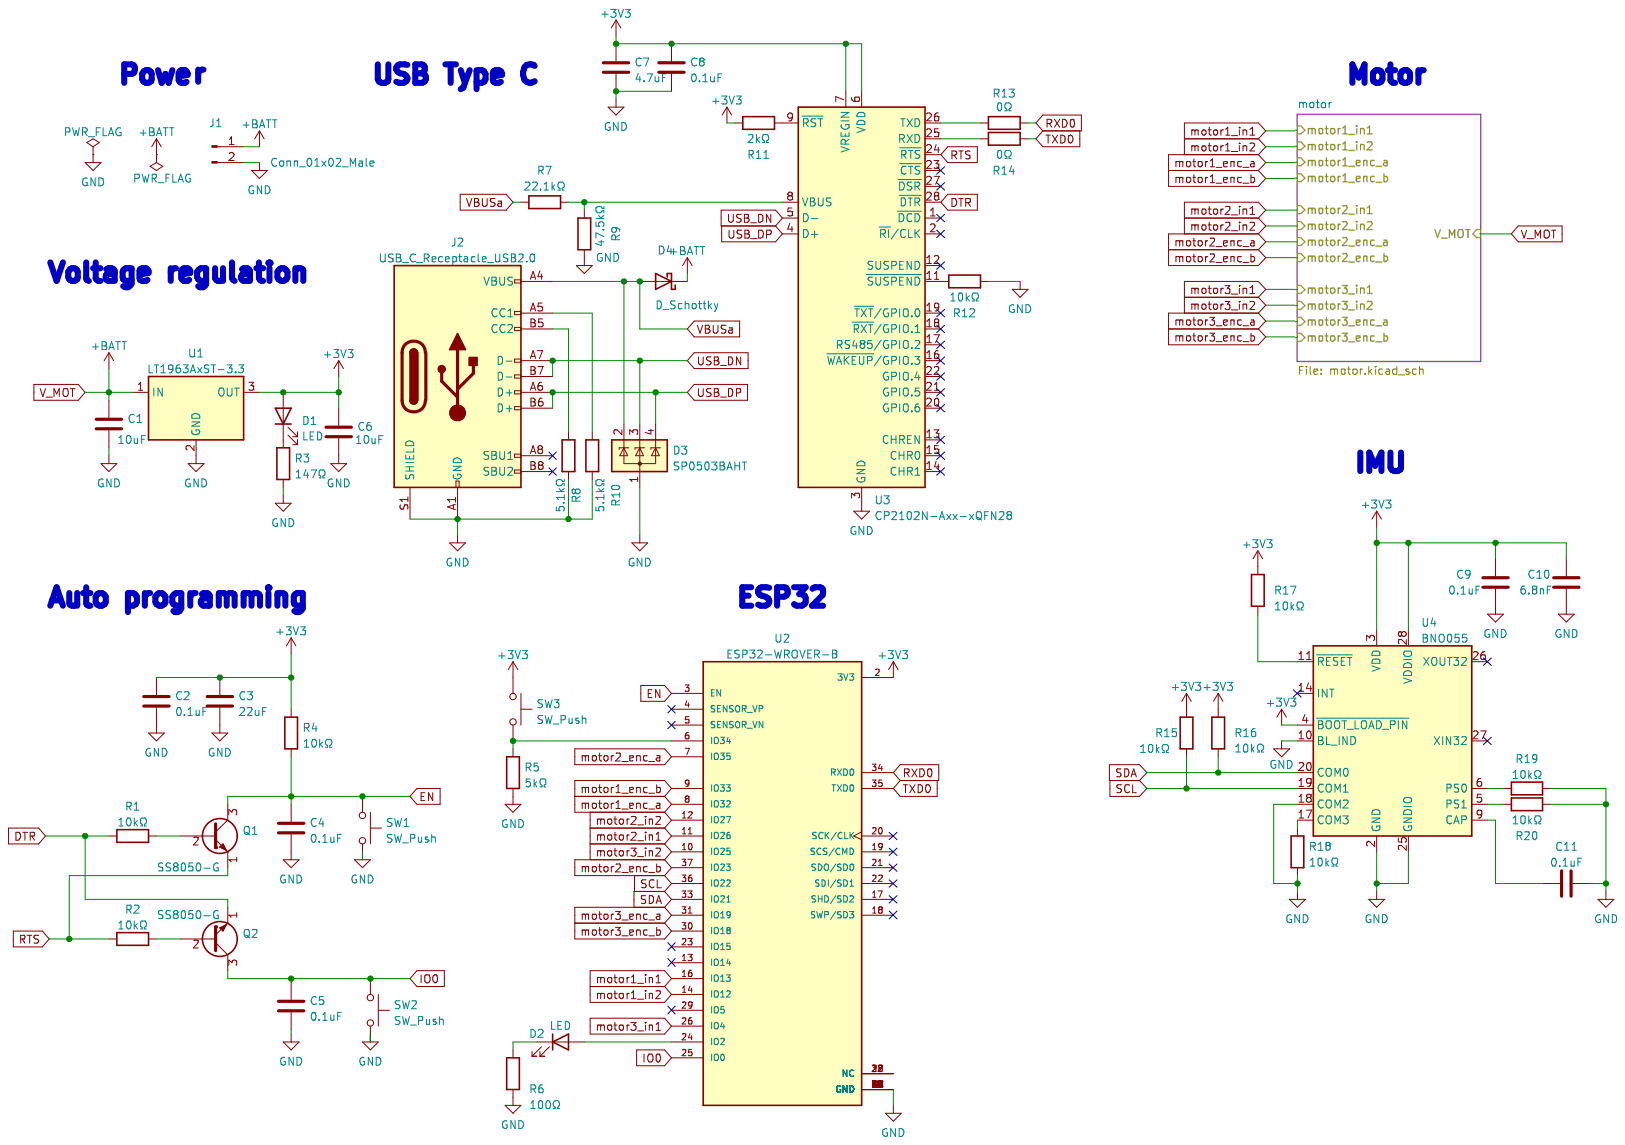
[picture p24: page 1]

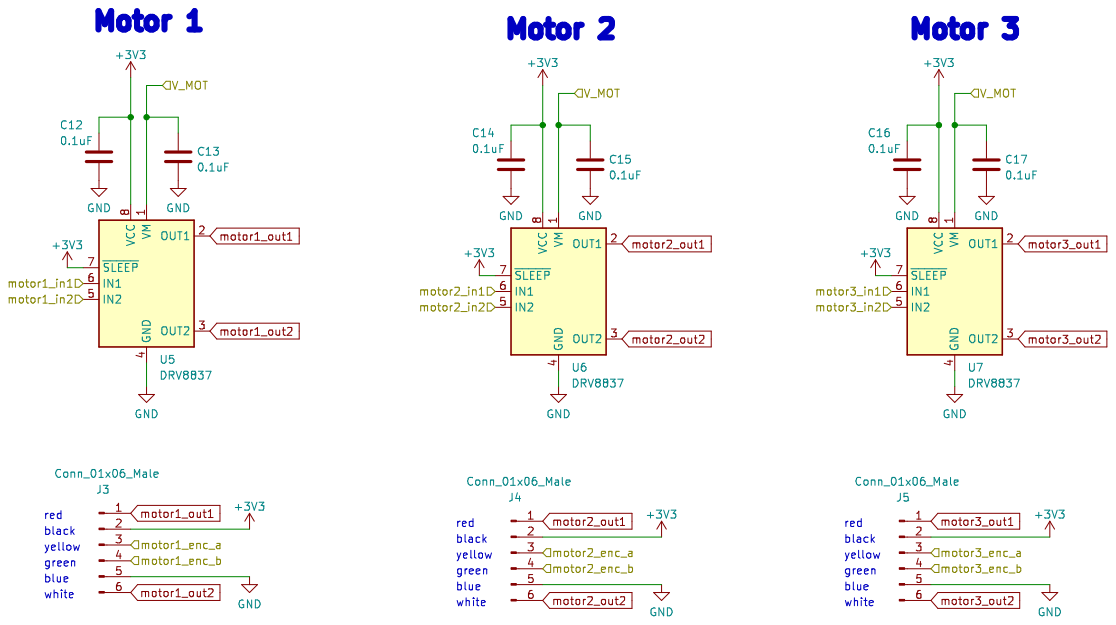
[picture p25: page 2]
