remmaTech12/omni-wheel/circuit/remote_controller/remote_controller.pdf

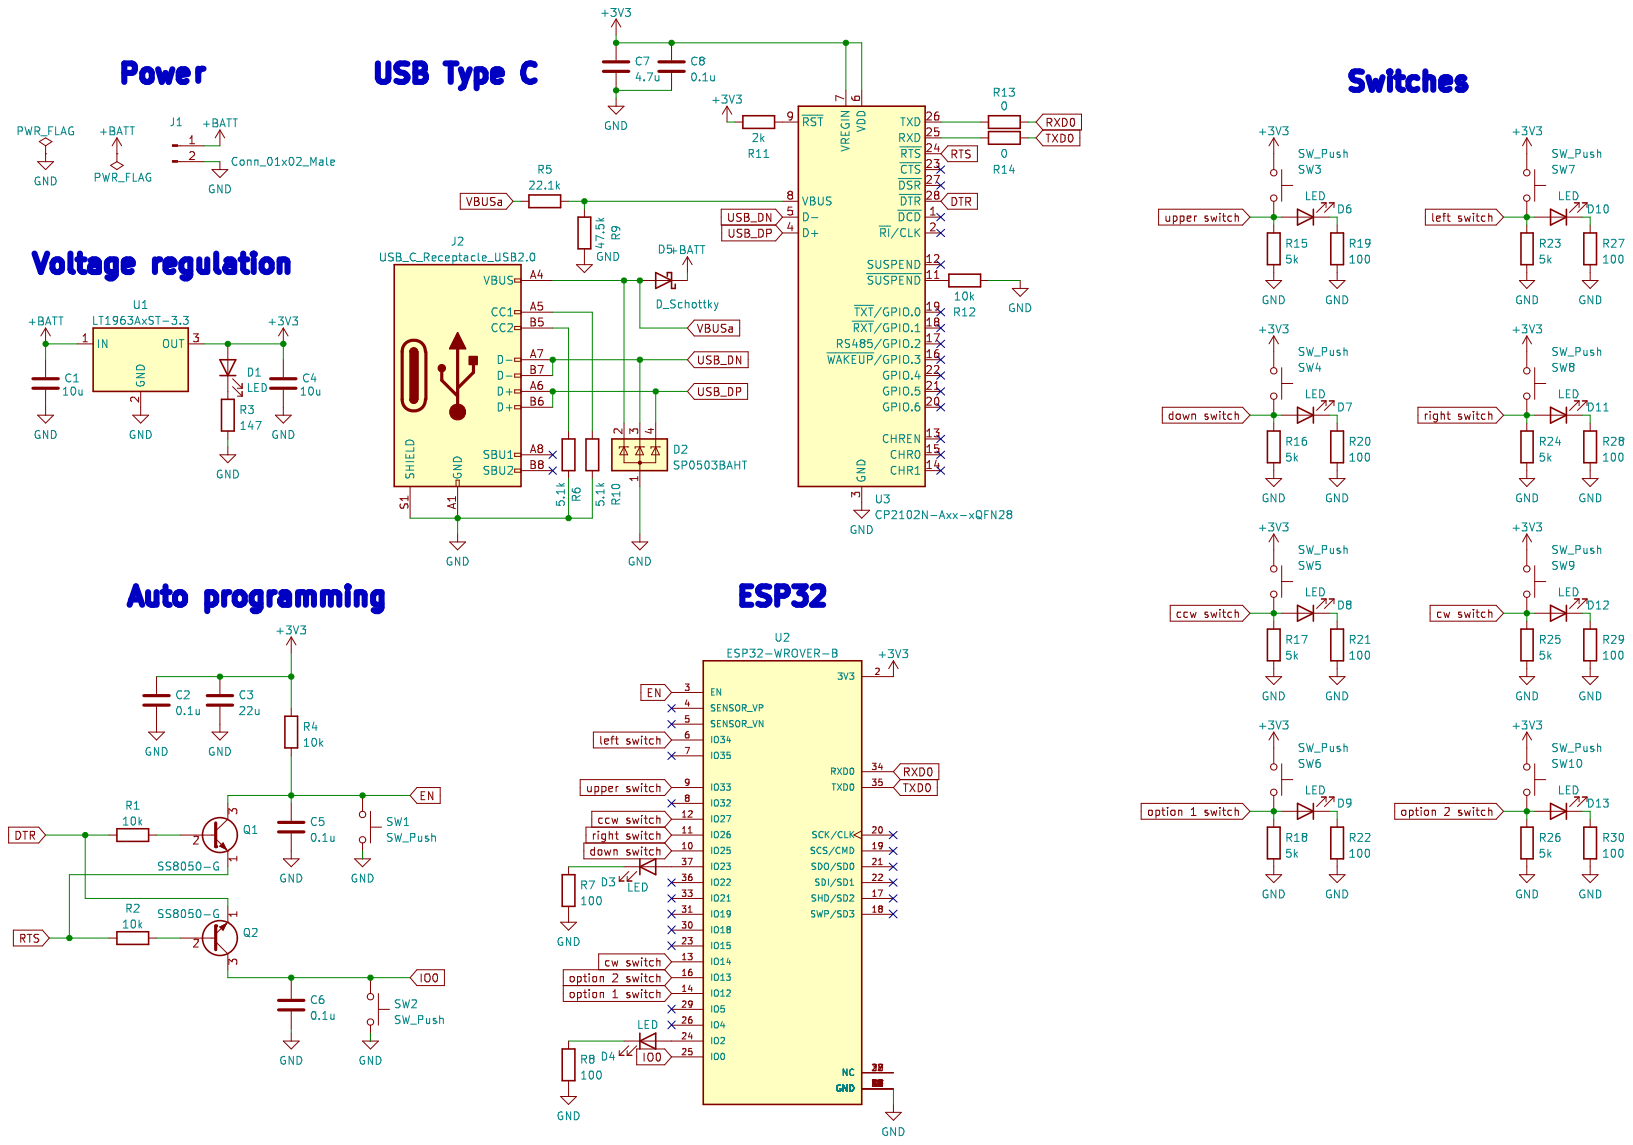
[picture p26: page 1]
