remmaTech12/omni-wheel/circuit/omni_wheel/omni_wheel.kicad_pcb

## KiCad design circuit/omni_wheel/omni_wheel.kicad_pcb (2024-12-15)

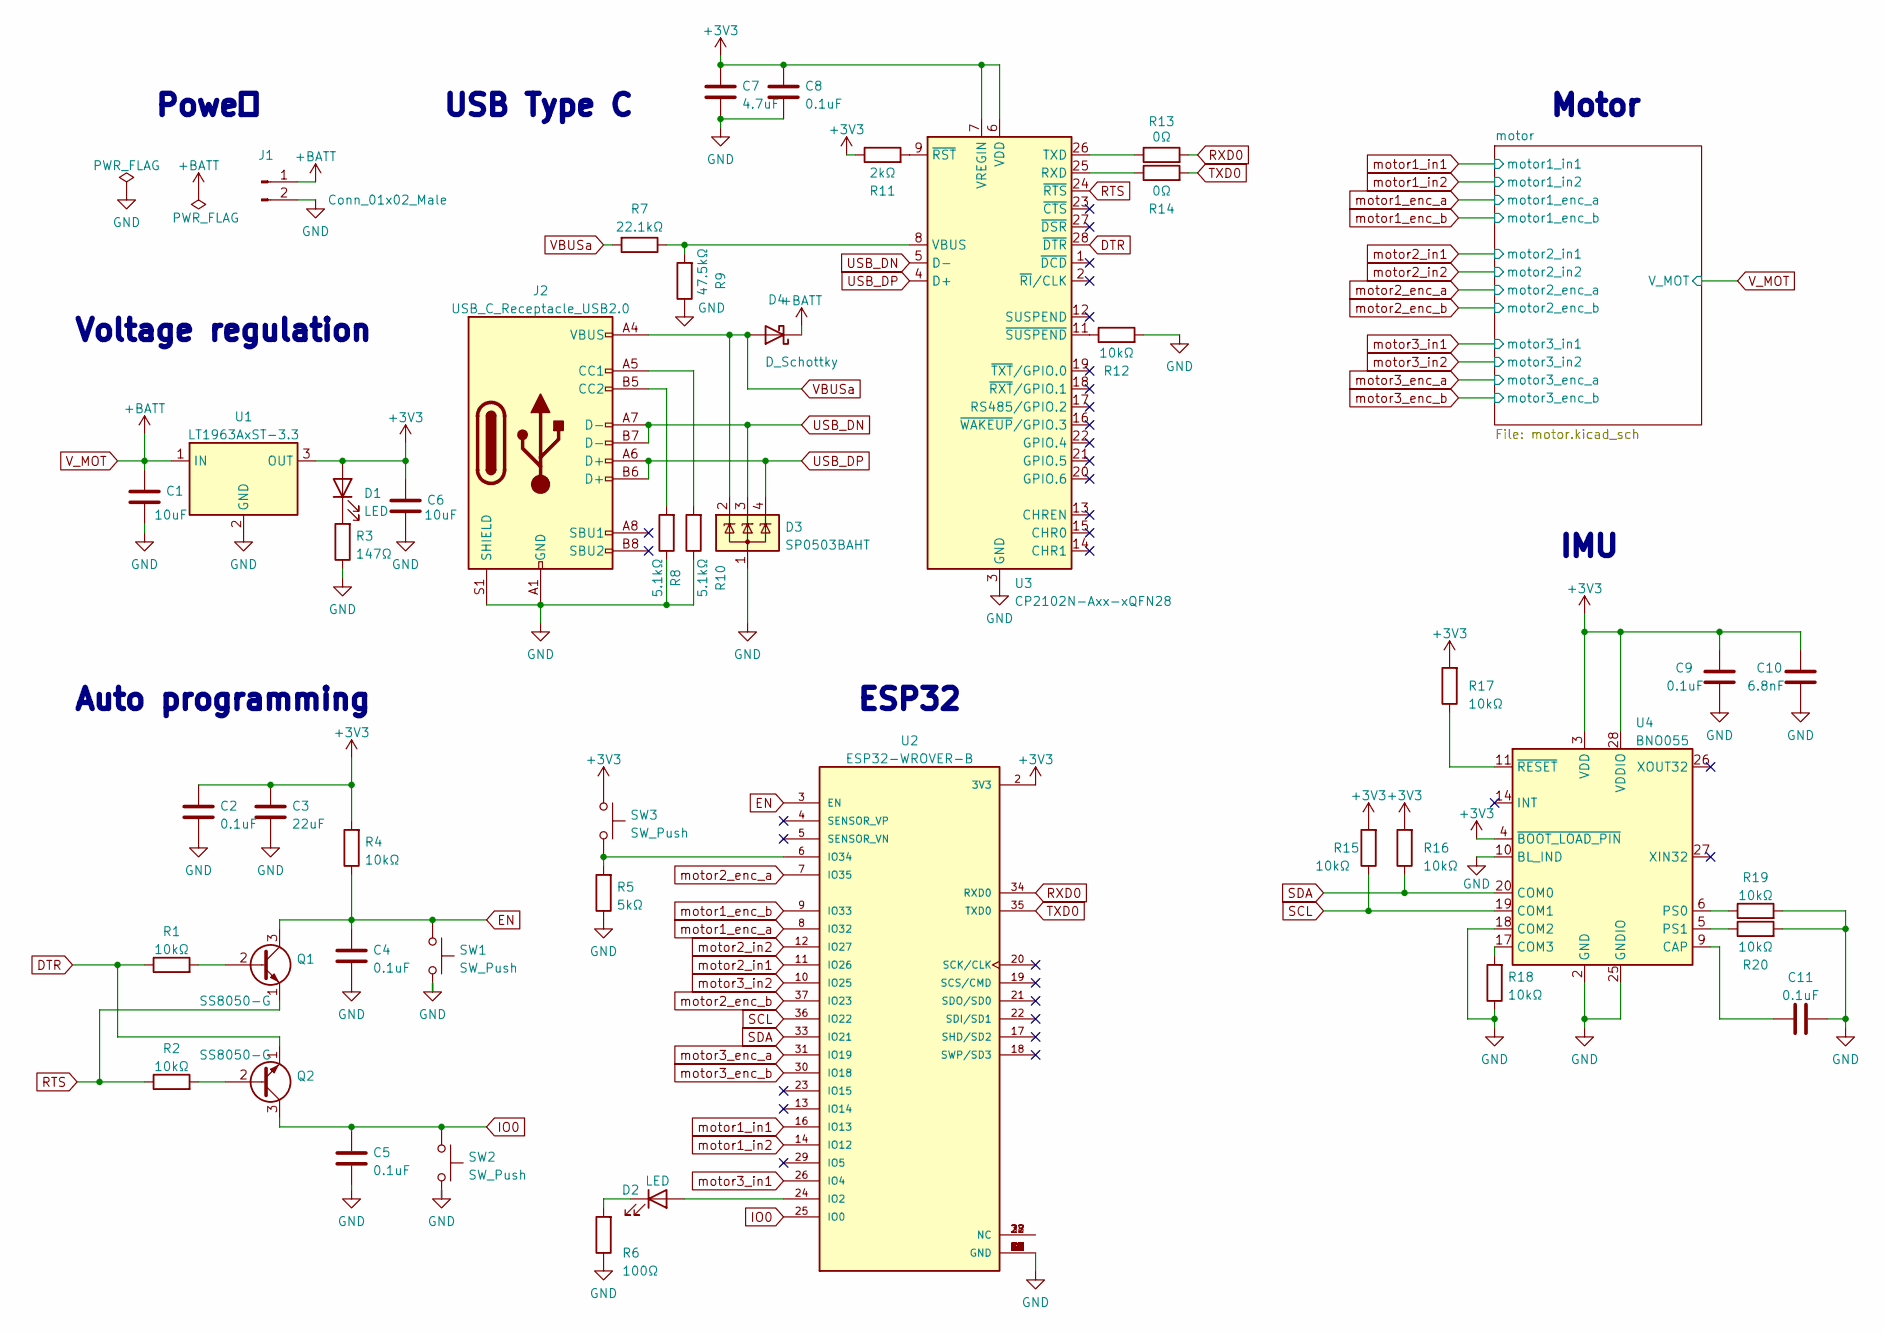
[picture p27: schematic omni_wheel.kicad_sch]

Parts:
C1, C6: 10uF; C_0603_1608Metric
C2, C4, C5, C8, C9, C11: 0.1uF; C_0603_1608Metric
C3: 22uF; C_0603_1608Metric
C7: 4.7uF; C_0603_1608Metric
C10: 6.8nF; C_0603_1608Metric
D1, D2: LED; D_0603_1608Metric
D3: SP0503BAHT; SOT-143
D4: D_Schottky; D_0603_1608Metric
J1: Conn_01x02_Male; PinSocket_1x02_P2.54mm_Vertical
J2: USB_C_Receptacle_USB2.0; USB_C_Receptacle_Amphenol_12401610E4-2A
Q1, Q2: SS8050-G; SOT-23
R1, R2, R4, R12, R15, R16, R17, R18, R19, R20: 10kΩ; R_0603_1608Metric
R3: 147Ω; R_0603_1608Metric
R5: 5kΩ; R_0603_1608Metric
R6: 100Ω; R_0603_1608Metric
R7: 22.1kΩ; R_0603_1608Metric
R8, R10: 5.1kΩ; R_0603_1608Metric
R9: 47.5kΩ; R_0603_1608Metric
R11: 2kΩ; R_0603_1608Metric
R13, R14: 0Ω; R_0603_1608Metric
SW1, SW2: SW_Push; SW_Push_1P1T_NO_CK_KMR2
SW3: SW_Push; SW_Push_1P1T_NO_6x6mm_H9.5mm
U1: LT1963AxST-3.3; SOT-223-3_TabPin2
U2: ESP32-WROVER-B; MODULE_ESP32-WROVER-B; PARTREV v1.6
U3: CP2102N-Axx-xQFN28; QFN-28-1EP_5x5mm_P0.5mm_EP3.35x3.35mm
U4: BNO055; LGA-28_5.2x3.8mm_P0.5mm

Connections:
+3V3: C2.1, C3.1, C6.1, C7.1, C8.1, C9.2, C10.2, D1.2 (A), R4.2, R11.1, R15.2, R16.2, R17.2, SW3.1, U1.3 (OUT), U2.2 (3V3), U3.6 (VDD), U3.7 (VREGIN), U4.3 (VDD), U4.4 (~BOOT_LOAD_PIN), U4.28 (VDDIO); also elsewhere on the board
DTR: Q2.1 (E), R1.1, U3.28 (~DTR)
EN: C4.1, Q1.3 (C), R4.1, SW1.1, U2.3 (EN)
GND: C1.2, C2.2, C3.2, C4.2, C5.2, C6.2, C7.2, C8.2, C9.1, C10.1, C11.2, D3.1 (A), J1.2, J2.A1 (GND), J2.A12 (GND), J2.B1 (GND), J2.B12 (GND), J2.S1 (SHIELD), R3.1, R5.1, R6.1, R8.1, R9.1, R10.1, R12.2, R18.1, R19.2, R20.2, SW1.2, SW2.2, U1.2 (GND), U2.1 (GND), U2.15 (GND), U2.38 (GND), U2.39 (GND), U2.40 (GND), U2.41 (GND), U2.42 (GND), U2.43 (GND), U2.44 (GND), U2.45 (GND), U2.46 (GND), U2.47 (GND), U2.48 (GND), U2.49 (GND), U2.50 (GND), U2.51 (GND), U2.52 (GND), U2.53 (GND), U2.54 (GND), U2.55 (GND), U2.56 (GND), U2.57 (GND), U2.58 (GND), U2.59 (GND), U3.3 (GND), U3.29 (GND), U4.2 (GND), U4.10 (BL_IND), U4.15 (GNDIO), U4.16 (GNDIO), U4.18 (COM2), U4.25 (GNDIO); also elsewhere on the board
IO0: C5.1, Q2.3 (C), SW2.1, U2.25 (IO0)
unnamed: C11.1, U4.9 (CAP)
unnamed: D1.1 (K), R3.2
unnamed: D2.1 (K), R6.2
unnamed: D2.2 (A), U2.24 (IO2)
unnamed: J2.A5 (CC1), R10.2
unnamed: J2.B5 (CC2), R8.2
unnamed: Q1.2 (B), R1.2
unnamed: Q2.2 (B), R2.2
unnamed: R5.2, SW3.2, U2.6 (IO34)
unnamed: R7.1, R9.2, U3.8 (VBUS)
unnamed: R11.2, U3.9 (~RST)
unnamed: R12.1, U3.11 (~SUSPEND)
unnamed: R13.1, U3.26 (TXD)
unnamed: R14.1, U3.25 (RXD)
unnamed: R17.1, U4.11 (~RESET)
unnamed: R18.2, U4.17 (COM3)
unnamed: R19.1, U4.6 (PS0)
unnamed: R20.1, U4.5 (PS1)
unnamed: U2.27 (NC), U2.28 (NC), U2.32 (NC)
RTS: Q1.1 (E), R2.1, U3.24 (~RTS)
RXD0: R13.2, U2.34 (RXD0)
SCL: R15.1, U2.36 (IO22), U4.19 (COM1)
SDA: R16.1, U2.33 (IO21), U4.20 (COM0)
TXD0: R14.2, U2.35 (TXD0)
USB_DN: D3.3 (K), J2.A7 (D-), J2.B7 (D-), U3.5 (D-)
USB_DP: D3.4 (K), J2.A6 (D+), J2.B6 (D+), U3.4 (D+)
VBUSa: D3.2 (K), D4.2 (A), J2.A4 (VBUS), J2.A9 (VBUS), J2.B4 (VBUS), J2.B9 (VBUS), R7.2
V_MOT: C1.1, D4.1 (K), J1.1, U1.1 (IN); also elsewhere on the board
motor1_enc_a: U2.8 (IO32); also elsewhere on the board
motor1_enc_b: U2.9 (IO33); also elsewhere on the board
motor1_in1: U2.16 (IO13); also elsewhere on the board
motor1_in2: U2.14 (IO12); also elsewhere on the board
motor2_enc_a: U2.7 (IO35); also elsewhere on the board
motor2_enc_b: U2.37 (IO23); also elsewhere on the board
motor2_in1: U2.11 (IO26); also elsewhere on the board
motor2_in2: U2.12 (IO27); also elsewhere on the board
motor3_enc_a: U2.31 (IO19); also elsewhere on the board
motor3_enc_b: U2.30 (IO18); also elsewhere on the board
motor3_in1: U2.26 (IO4); also elsewhere on the board
motor3_in2: U2.10 (IO25); also elsewhere on the board

Notes on the sheet:
Motor
Poweｒ
Auto programming
IMU
USB Type C
Voltage regulation
ESP32

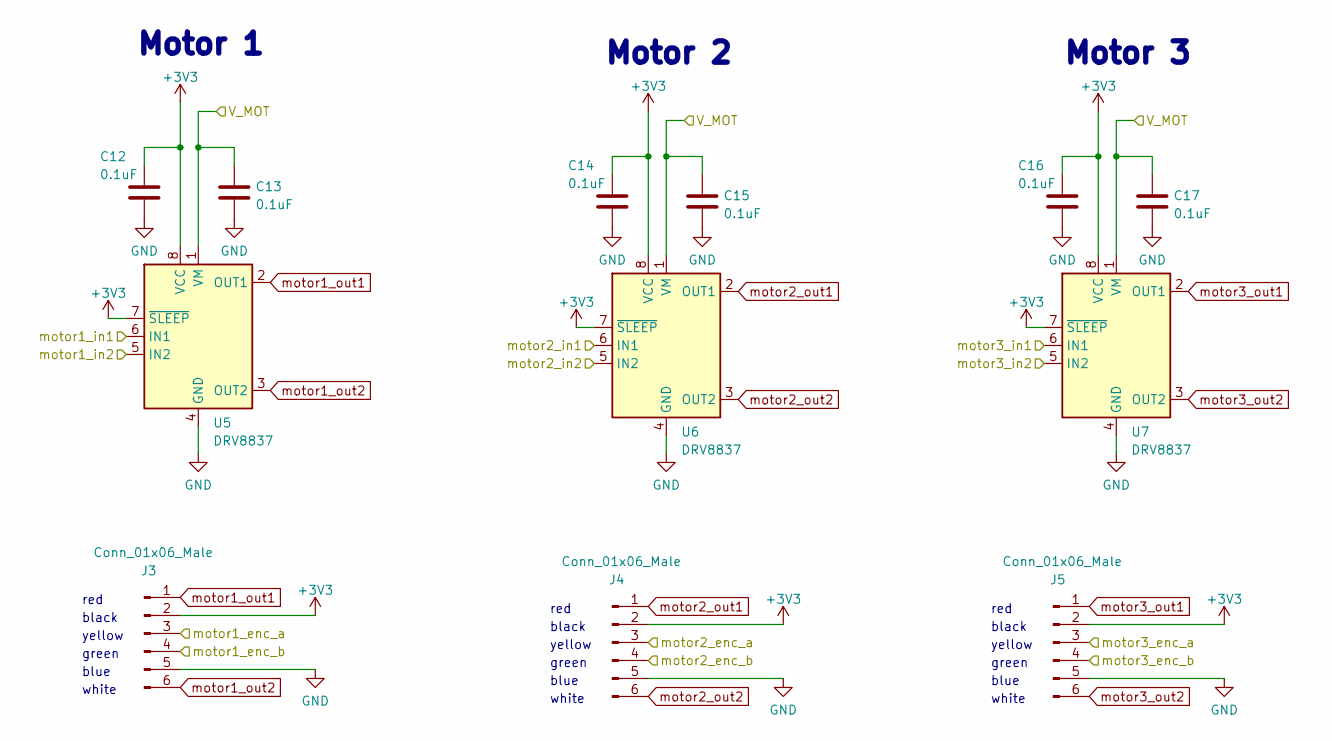
[picture p28: schematic motor.kicad_sch]

Parts:
C12, C13, C14, C15, C16, C17: 0.1uF; C_0603_1608Metric
J3, J4, J5: Conn_01x06_Male; PinHeader_1x06_P2.54mm_Vertical
U5, U6, U7: DRV8837; WSON-8-1EP_2x2mm_P0.5mm_EP0.9x1.6mm

Connections:
+3V3: C12.1, C14.1, C16.1, J3.2, J4.2, J5.2, U5.7 (~SLEEP), U5.8 (VCC), U6.7 (~SLEEP), U6.8 (VCC), U7.7 (~SLEEP), U7.8 (VCC); also elsewhere on the board
GND: C12.2, C13.2, C14.2, C15.2, C16.2, C17.2, J3.5, J4.5, J5.5, U5.4 (GND), U5.9 (GND), U6.4 (GND), U6.9 (GND), U7.4 (GND), U7.9 (GND); also elsewhere on the board
V_MOT: C13.1, C15.1, C17.1, U5.1 (VM), U6.1 (VM), U7.1 (VM); also elsewhere on the board
motor1_enc_a: J3.3; also elsewhere on the board
motor1_enc_b: J3.4; also elsewhere on the board
motor1_in1: U5.6 (IN1); also elsewhere on the board
motor1_in2: U5.5 (IN2); also elsewhere on the board
motor1_out1: J3.1, U5.2 (OUT1)
motor1_out2: J3.6, U5.3 (OUT2)
motor2_enc_a: J4.3; also elsewhere on the board
motor2_enc_b: J4.4; also elsewhere on the board
motor2_in1: U6.6 (IN1); also elsewhere on the board
motor2_in2: U6.5 (IN2); also elsewhere on the board
motor2_out1: J4.1, U6.2 (OUT1)
motor2_out2: J4.6, U6.3 (OUT2)
motor3_enc_a: J5.3; also elsewhere on the board
motor3_enc_b: J5.4; also elsewhere on the board
motor3_in1: U7.6 (IN1); also elsewhere on the board
motor3_in2: U7.5 (IN2); also elsewhere on the board
motor3_out1: J5.1, U7.2 (OUT1)
motor3_out2: J5.6, U7.3 (OUT2)

Notes on the sheet:
blue
red
yellow
Motor 3
black
white
green
Motor 2
Motor 1

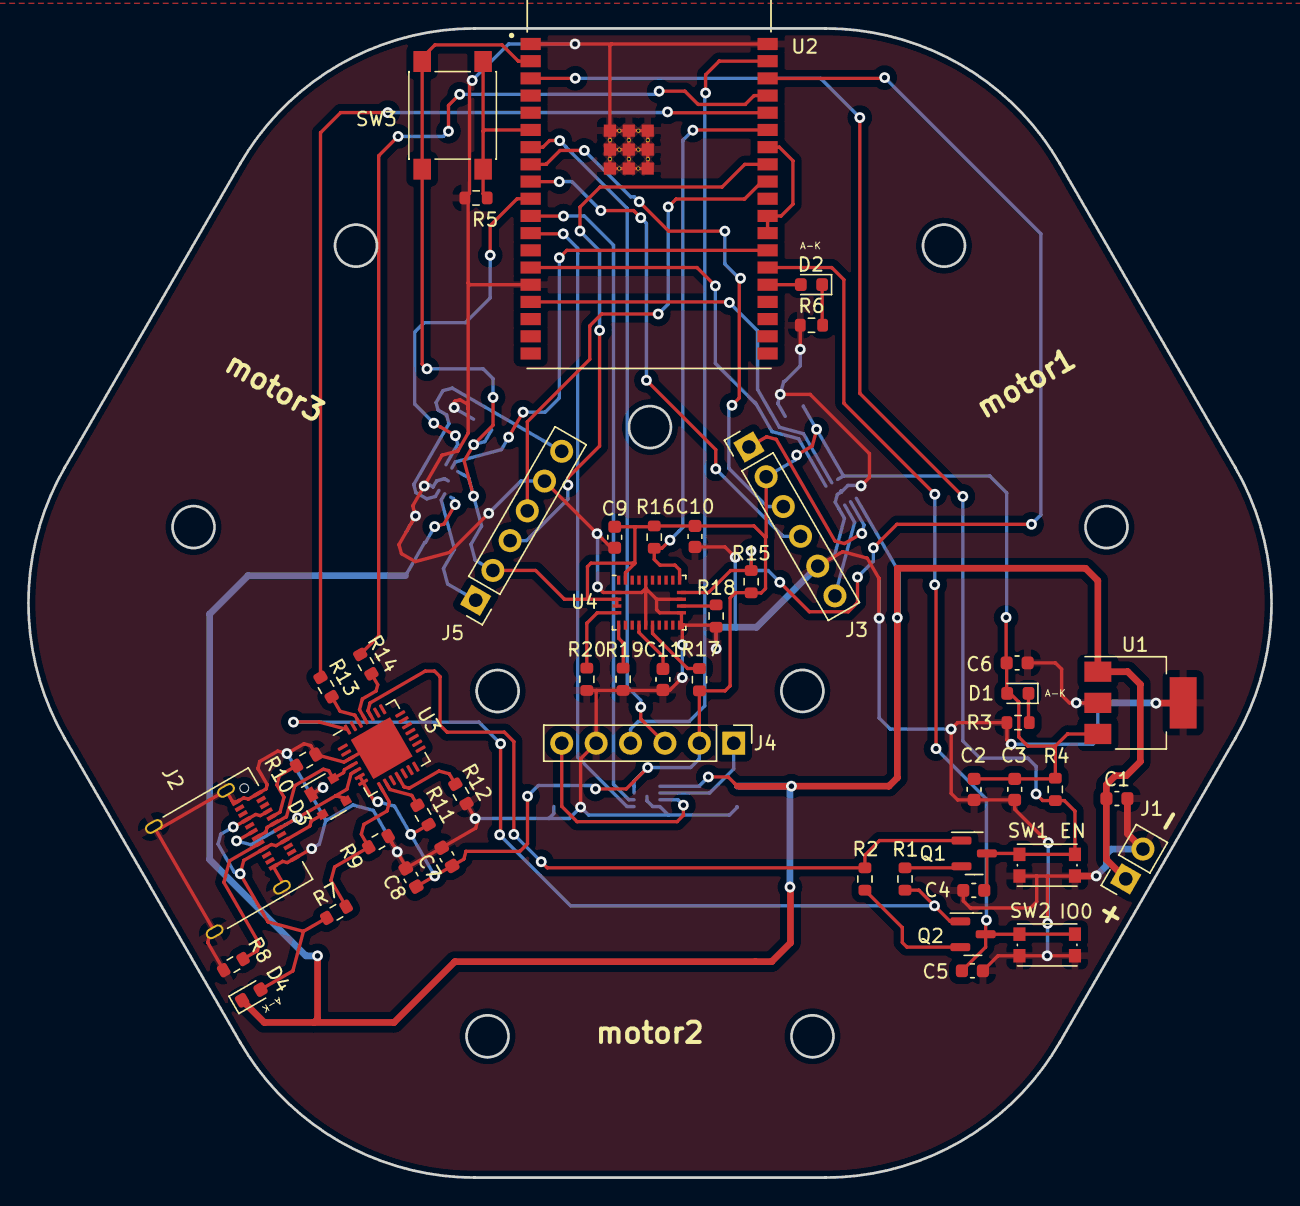
[picture p29: board omni_wheel.kicad_pcb from above]

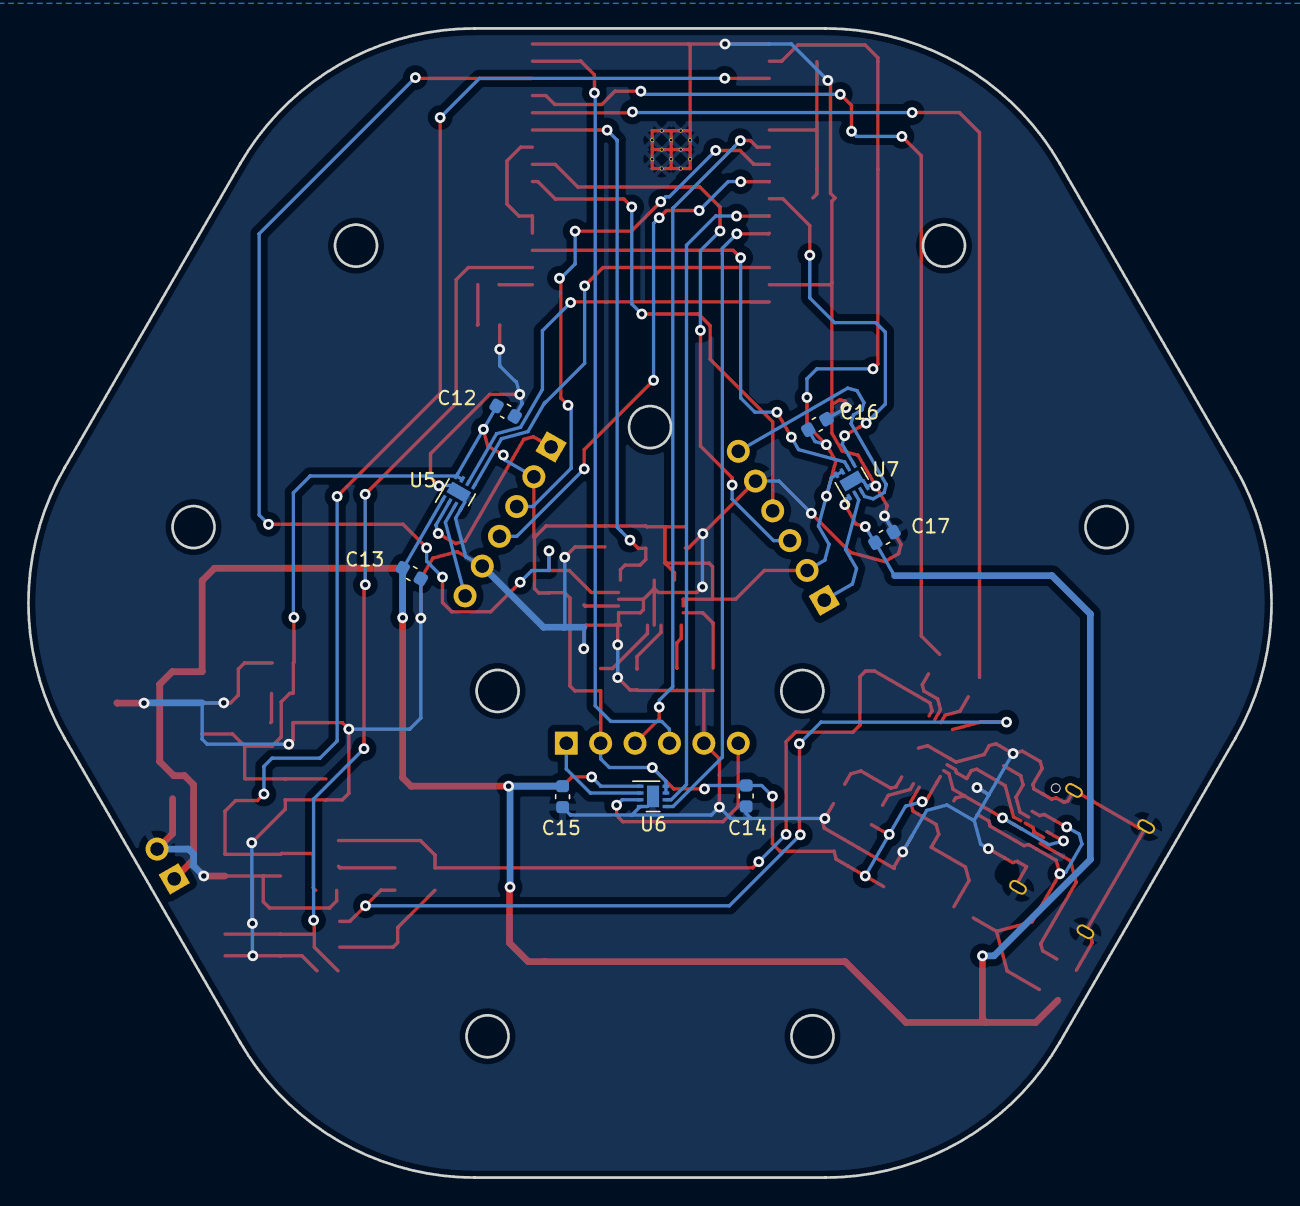
[picture p30: board omni_wheel.kicad_pcb from below]

Board: 2 copper layers, 91.8 x 84.9 mm, 58 parts (9 on the bottom side), 51 nets.
