remmaTech12/omni-wheel/circuit/remote_controller/remote_controller.kicad_pcb

## KiCad design circuit/remote_controller/remote_controller.kicad_pcb (2024-05-18)

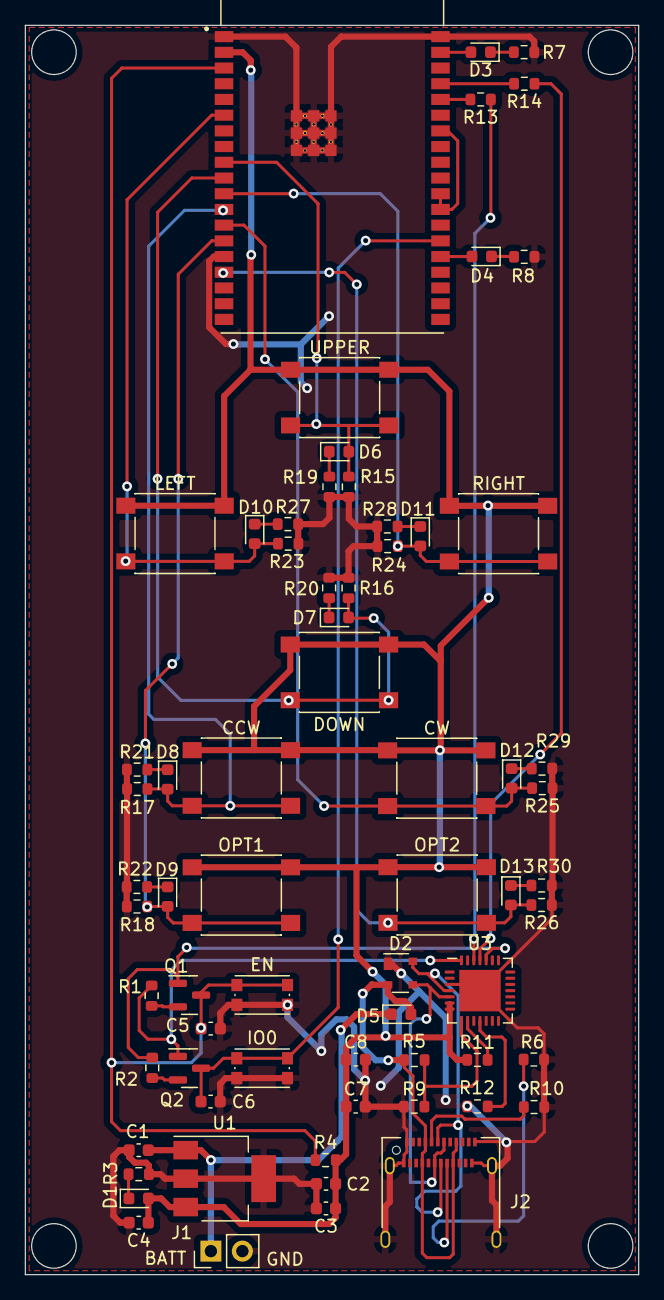
[picture p31: board remote_controller.kicad_pcb from above]

Board: 2 copper layers, 49.6 x 101.0 mm, 68 parts (0 on the bottom side), 43 nets.

Parts:
C1, C4: 10u; C_0603_1608Metric
C2, C5, C6, C8: 0.1u; C_0603_1608Metric
C3: 22u; C_0603_1608Metric
C7: 4.7u; C_0603_1608Metric
CCW: SW_Push; SW_Push_1P1T_NO_6x6mm_H9.5mm
CW: SW_Push; SW_Push_1P1T_NO_6x6mm_H9.5mm
D1, D3, D4, D6, D7, D8, D9, D10, D11, D12, D13: LED; D_0603_1608Metric
D2: SP0503BAHT; SOT-143
D5: D_Schottky; D_0603_1608Metric
DOWN: SW_Push; SW_Push_1P1T_NO_6x6mm_H9.5mm
EN: SW_Push; SW_Push_1P1T_NO_CK_KMR2
IO0: SW_Push; SW_Push_1P1T_NO_CK_KMR2
J1: Conn_01x02_Male; PinHeader_1x02_P2.54mm_Vertical
J2: USB_C_Receptacle_USB2.0; USB_C_Receptacle_Amphenol_12401610E4-2A
LEFT: SW_Push; SW_Push_1P1T_NO_6x6mm_H9.5mm
OPT1, OPT2: SW_Push; SW_Push_1P1T_NO_6x6mm_H9.5mm
Q1, Q2: SS8050-G; SOT-23
R1, R2, R4, R12: 10k; R_0603_1608Metric
R3: 147; R_0603_1608Metric
R5: 22.1k; R_0603_1608Metric
R6, R10: 5.1k; R_0603_1608Metric
R7, R8, R19, R20, R21, R22, R27, R28, R29, R30: 100; R_0603_1608Metric
R9: 47.5k; R_0603_1608Metric
R11: 2k; R_0603_1608Metric
R13, R14: 0; R_0603_1608Metric
R15, R16, R17, R18, R23, R24, R25, R26: 5k; R_0603_1608Metric
RIGHT: SW_Push; SW_Push_1P1T_NO_6x6mm_H9.5mm
U1: LT1963AxST-3.3; SOT-223-3_TabPin2
U2: ESP32-WROVER-B; MODULE_ESP32-WROVER-B
U3: CP2102N-Axx-xQFN28; QFN-28-1EP_5x5mm_P0.5mm_EP3.35x3.35mm
UPPER: SW_Push; SW_Push_1P1T_NO_6x6mm_H9.5mm

Connections:
+3V3: C2.1, C3.1, C4.1, C7.1, C8.1, CCW.1, CW.1, D1.2 (A), DOWN.1, LEFT.1, OPT1.1, OPT2.1, R4.2, R11.1, RIGHT.1, U1.3 (OUT), U2.2 (3V3), U3.6 (VDD), U3.7 (VREGIN), UPPER.1
+BATT: C1.1, D5.1 (K), J1.1, U1.1 (IN)
DTR: Q2.1 (E), R1.1, U3.28 (~DTR)
EN: C5.1, EN.1, Q1.3 (C), R4.1, U2.3 (EN)
GND: C1.2, C2.2, C3.2, C4.2, C5.2, C6.2, C7.2, C8.2, D2.1 (A), EN.2, IO0.2, J1.2, J2.A1 (GND), J2.A12 (GND), J2.B1 (GND), J2.B12 (GND), J2.S1 (SHIELD), R3.1, R6.1, R7.1, R8.1, R9.1, R10.1, R12.2, R15.1, R16.1, R17.1, R18.1, R19.1, R20.1, R21.1, R22.1, R23.1, R24.1, R25.1, R26.1, R27.1, R28.1, R29.1, R30.1, U1.2 (GND), U2.1 (GND), U2.15 (GND), U2.38 (GND), U2.39 (GND), U2.40 (GND), U2.41 (GND), U2.42 (GND), U2.43 (GND), U2.44 (GND), U2.45 (GND), U2.46 (GND), U2.47 (GND), U2.48 (GND), U2.49 (GND), U2.50 (GND), U2.51 (GND), U2.52 (GND), U2.53 (GND), U2.54 (GND), U2.55 (GND), U2.56 (GND), U2.57 (GND), U2.58 (GND), U2.59 (GND), U3.3 (GND), U3.29 (GND)
IO0: C6.1, IO0.1, Q2.3 (C), U2.25 (IO0)
unnamed: D1.1 (K), R3.2
unnamed: D3.1 (K), R7.2
unnamed: D3.2 (A), U2.37 (IO23)
unnamed: D4.1 (K), R8.2
unnamed: D4.2 (A), U2.24 (IO2)
unnamed: D6.1 (K), R19.2
unnamed: D7.1 (K), R20.2
unnamed: D8.1 (K), R21.2
unnamed: D9.1 (K), R22.2
unnamed: D10.1 (K), R27.2
unnamed: D11.1 (K), R28.2
unnamed: D12.1 (K), R29.2
unnamed: D13.1 (K), R30.2
unnamed: J2.A5 (CC1), R10.2
unnamed: J2.B5 (CC2), R6.2
unnamed: Q1.2 (B), R1.2
unnamed: Q2.2 (B), R2.2
unnamed: R5.1, R9.2, U3.8 (VBUS)
unnamed: R11.2, U3.9 (~RST)
unnamed: R12.1, U3.11 (~SUSPEND)
unnamed: R13.1, U3.26 (TXD)
unnamed: R14.1, U3.25 (RXD)
unnamed: U2.27 (NC), U2.28 (NC), U2.32 (NC)
RTS: Q1.1 (E), R2.1, U3.24 (~RTS)
RXD0: R13.2, U2.34 (RXD0)
TXD0: R14.2, U2.35 (TXD0)
USB_DN: D2.3 (K), J2.A7 (D-), J2.B7 (D-), U3.5 (D-)
USB_DP: D2.4 (K), J2.A6 (D+), J2.B6 (D+), U3.4 (D+)
VBUSa: D2.2 (K), D5.2 (A), J2.A4 (VBUS), J2.A9 (VBUS), J2.B4 (VBUS), J2.B9 (VBUS), R5.2
ccw switch: CCW.2, D8.2 (A), R17.2, U2.12 (IO27)
cw switch: CW.2, D12.2 (A), R25.2, U2.13 (IO14)
down switch: D7.2 (A), DOWN.2, R16.2, U2.10 (IO25)
left switch: D10.2 (A), LEFT.2, R23.2, U2.6 (IO34)
option 1 switch: D9.2 (A), OPT1.2, R18.2, U2.14 (IO12)
option 2 switch: D13.2 (A), OPT2.2, R26.2, U2.16 (IO13)
right switch: D11.2 (A), R24.2, RIGHT.2, U2.11 (IO26)
upper switch: D6.2 (A), R15.2, U2.9 (IO33), UPPER.2
