remmaTech12/omni-wheel/software/omni_robot/main/include/pin_allocation.hpp

#define MOTOR1_ENC_A_PIN 32
#define MOTOR1_ENC_B_PIN 33
#define MOTOR1_IN1_PIN 13
#define MOTOR1_IN2_PIN 12

#define MOTOR2_ENC_A_PIN 35
#define MOTOR2_ENC_B_PIN 23
#define MOTOR2_IN1_PIN 26
#define MOTOR2_IN2_PIN 27

#define MOTOR3_ENC_A_PIN 19
#define MOTOR3_ENC_B_PIN 18
#define MOTOR3_IN1_PIN 4
#define MOTOR3_IN2_PIN 25

#define LED_PIN 2
#define SW_PIN 34
