remmaTech12/omni-wheel/(commit log)

2023-08-05 add velocity calculation.
2024-03-29 Add remote controller circuit.
    [remote_controller.csv, remote_controller.kicad_pcb, remote_controller.kicad_sch]
2024-03-29 Added csv file.
    [remote_controller.csv, remote_controller.kicad_sch]
2024-03-31 Apply the circuit design; add holes at each corner.
    [remote_controller.kicad_pcb]
2024-03-31 Add circuit diagram pdf and parts list.
    [remote_controller_bom_pcbway.xlsx]
2024-05-18 as of 20240518
    [remote_controller.kicad_pcb, remote_controller_bom_pcbway.xlsx]
2024-05-18 add centroids and gerber files.
    [remote_controller-B_Cu.gbl, remote_controller-B_Mask.gbs, remote_controller-B_Paste.gbp, remote_controller-B_Silkscreen.gbo, remote_controller-Edge_Cuts.gm1, remote_controller-F_Cu.gtl, remote_controller-F_Mask.gts, remote_controller-F_Paste.gtp]
2024-05-18 add plot
    [remote_controller-B_Cu.gbl, remote_controller-B_Mask.gbs, remote_controller-B_Paste.gbp, remote_controller-B_Silkscreen.gbo, remote_controller-Edge_Cuts.gm1, remote_controller-F_Cu.gtl, remote_controller-F_Mask.gts, remote_controller-F_Paste.gtp]
2024-05-19 temporary commit for arduino software
2024-05-26 messy code; but done classification of motor.
2024-05-26 overall motor.hpp refactoring done.
2024-05-26 utilize the array for motor instance.
2024-05-26 control 3 motors independently.
2024-05-26 separate PID instances.
2024-06-08 add finalized BOM.
    [T-1JP1W790621A-1sets-remote_controller_bom_pcbway_2024-04-16.xls]
2024-07-07 add imu and change PINs.
2024-08-10 Modify PIN alias names.
2024-08-11 PIN allocation change: all the motor worked.
2024-08-11 utilize bno sensor.
2024-08-11 add switch.
2024-11-07 update 3d printed parts.
    [omni-wheel-assy.FCStd, omni-wheel-base-base.stl, omni-wheel-base.FCStd, omni-wheel-bracket-bracket.stl, omni-wheel-bracket.FCStd]
2024-11-07 update 3dprint parts data.
    [omni-wheel-assy-omni-wheel-bracket.dxf, omni-wheel-base-base-conv.dxf, omni-wheel-base-base-without-fillet.dxf, omni-wheel-base-base.dxf, omni-wheel-base-baseFillet.dxf, omni-wheel-bracket-base-base.stl, omni-wheel-bracket-base.FCStd]
2024-11-07 add omni-wheel circuit.
    [motor.kicad_sch, omni-wheel-base_bom_20240831.xls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]
2024-12-01 redesign omni-wheel base.
    [omni-wheel-base-base.dxf, omni-wheel-base.FCStd]
2024-12-01 connect nsleep to high and remove unnecessary switch.
    [motor.kicad_sch]
2024-12-01 redesign the PCB: the direction of parts.
    [omni_wheel.kicad_pcb]
2024-12-01 connect nsleep to high and remove unnecessary switch (2/2).
    [omni_wheel.kicad_sch]
2024-12-01 add csv and xml files.
    [omni_wheel.csv]
2024-12-01 add purchase order files.
    [omni-wheel-base_bom_20240831.xls, omni-wheel-base_bom_20241122a.xls]
2024-12-02 modified 3d print part for motor bracket.
    [omni-wheel-bracket-base-base.stl, omni-wheel-bracket-base.FCStd, omni-wheel-bracket-bracket.stl, omni-wheel-bracket.FCStd]
2024-12-15 Revised based on review 2024 Dec 7th.
    [Quotation for T-1JP6W790621A-1sets-omni-wheel-base_bom_20241122a(2024-12-07).xls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]
2024-12-20 thicken and add reiforcement material for 3D print parts.
    [omni-wheel-bracket-bracket.stl, omni-wheel-bracket.FCStd]
2024-12-26 Make the bracket base thinner.
    [omni-wheel-bracket-base-base.stl, omni-wheel-bracket-base.FCStd]
2024-12-31 rotate motor only when the switch is pressed.
2025-01-01 refactoring for remote controller and omni-wheel robot.
2025-01-01 fix a bug on the remote controller key bind.
    [main.ino]
2025-01-01 fix bug: motor direction and horizontal movement.
    [main.ino, motor.hpp]
2025-01-17 temporarily messy code: inverted pendulum worked.
    [main.ino]
2025-01-17 inverted pendulum code refactoring
    [main.ino]
2025-01-17 separate pin allocation hpp.
2025-01-17 stop motor when command is not coming in NOT inverted_pendulum mode.
2025-01-17 switch inverted pendulum mode or not by pressing button.
    [main.ino]
2025-01-17 [refactor] button press judgement process
2025-01-26 put remote controller submission data in a single directory.
    [bom.xls]
2025-01-26 rename directory
    [bom.xls]
2025-01-26 rename file.
    [bom.xls]
2025-01-26 add pid for inverted pendulum control.
    [body_control.hpp, pid.hpp]
2025-01-29 disable imu to make it work with connecting to battery.
